bicknell/DCC-Mobile-Decoder/hardware/decoders/README.md

# Index of Decoders

* [Wired-N-1A-8-1](Wired-N-1A-8-1/) Solder Pads, N scale, 1A, 8 function, 9mm x 25mm
