bicknell/DCC-Mobile-Decoder/hardware/decoders/Atlas-N-1A-2-GP40-1/Atlas-N-1A-2-GP40-1.jpg

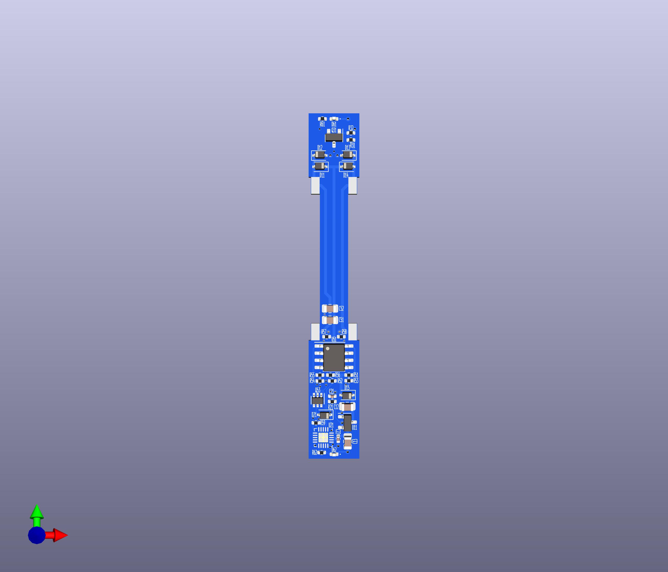
hardware/decoders/Atlas-N-1A-2-GP40-1/Atlas-N-1A-2-GP40-1.jpg
