bicknell/DCC-Mobile-Decoder/hardware/reference/Breadboard-2/CALCULATIONS.xlsx

Sheet: Project
Project Requirements
Description
These are the input electrical requirements as determined by the project specifications. They are used to validate the circuitry is within specifications.
Properties
Ref | Name | Value | Unit | Comment
 | DCC V(max) | 30 | Volts | NMRA Maximum Track Voltage is 27v, the project should be designed with some headroom.
 | DCC V(min) | 6 | Volts | NMRA Minimum Track Voltage is 7 volts, the project should be designed with some headroom.
 | DCC dropout | 4e-05 | Seconds | The maximum duration of the no-power time when the DCC signal switches polarity.
 | µC V | 3.3 | Volts | Operating voltage of the µC.
 | If | 0.1 | Amps | Maximum function current supported.
 | Imax | 1 | Amps | Maximum current across decoder.
 | Ireadback | 0.06 | Amps | NMRA Minimum Readback Pulse
Component Notes
The DCC Signal and Function Outputs need a small signal N-Channel MOSFET. The schematic does not indicate ESD protection on the MOSFET, but it is advisable on any decoder that will see repeated handling like this development board. Functionally any small signal MOSFET with a Vds > 40V, Id > 100ma, and a Vgs < 3.5V are acceptable substututions, including the popular and widely copied 2N7000, 2N7002 and BSS138 parts. Many of the clones have better specifications than the original versions. The ElecSuper BSS138K was chosen as an enhanced BSS138 copy with added ESD protection and high availability and low price at the time this was written.
The Motor Drive requires higher current N & P-Channel MOSFETs to form the H-Bridge. The schematic does not indicate ESD protection on the MOSFET, but it is advisable on any decoder that will see repeated handling like this development board. While the DCC voltage only goes to 27V and the project only requires 1A continuous current, it is advisable to greately over-specify the MOSFETs capabilities so that they operate at a cooler temperature. It is recommended to use parts with Vds > 60V, Id > 2A. Vgs for the P-Channel is not critical due to the drive method. Vgs for the N-Channel must be below the voltage of the MicroController. The Toshiba SSM3J356R,LF was chosen for the P-Channel as it is one of very few P-Channel MOSFETs in this range to include ESD protection. Popular options without ESD protection are the "2309" clones (NEC2309, SI2309, PJM2309, LP2309, etc) and they generally have Id ratings between 1.5A and 2.5A. The Nexperia PMV55ENEA was chosen for the N-Channel as it includes ESD protection. There are several other choices with ESD protection such as the Toshiba SSM3K2615R, or Vishay SQ2364. Popular options without ESD protection are the "2310" clones (CJ2310, AP2310, SL2310, MDD2310, HXY2310AI, SL2310) and they generally have Id ratings between 2A and 3.5A.
For all passive components 0805 (or equivilent) packages have been used. All transistor and MOSFETs are SOT-23. This is a balance of small size but also potential repairability as this is a development board and may be damaged in testing. It should be possible to replace a component by hand without too much difficulty.
When chosing resistors care has been taken to stay with popular E6/E12/E24 values whenever possible, and to design the circuit so 1/16W resistors are of sufficient power handling. This is to support shrinking the circuit to 0201 components which are not generally available in 1/8W variants. While the design allows for 1/16W resistors, the specification is for 1/8W in all cases as they are more readily available in 0805 packages and provide an additional margin of safety.
The exact linear regulator in the Power Supply is not critical. The SE8633X2-HF was chosen entirely based on availability and price. To meet the specifications at the lowest voltages generally an LDO part is required. Take care when swapping regulators to insure the pinout is the same, and the input and output capacitors are sufficient.
The White LEDs in the F0F/F0R and Diag LEDs sections are not critical. The chosen parts were avaialble and low cost at the time of this writing. Any White LED with a Vforward of ~2.9v should work fine. Note that in a real decoder the selection of the F0F and F0R are likely to be important. These LEDs will need to have a color and brightness appropriate to the locomotive, and may need alternate mounting styles such as an edge mount LED or a T1.5 package mounted off the end of the board.

Sheet: 1x Power Supply
Power Supply
Description
SE8633X2-HF is designed for power-sensitive applications. It includes a precision and high voltage input stage, an ultra-low-power bias current branch, and results in a ultra-low-power and low-dropout linear regulator.
Circuit Usage
Regulator to supply power to the µC. A LDO Linear Regulator is acceptable here because the draw by the µC is very small, < 4ma in general. The largest draw on the µC is the directly connected LEDs for the F0F/F0R functions. Diode D15 prevents the motor (Vdrive) from draining capacitor C11 when there is an interruption in power on the track. Provisions are made for a "super-capacitor" to improve performance when there is poor electrical connectivity to the track. C11 may be user installed, up to 1 Farad (1000uF) using capacitors with pitch 2.5mm or 5mm up to a diameter of 10mm.
Properties
Ref | Name | Value | Unit | Comment
D11-D15 | Vrev(max) | 40 | Volts | Maximum repeated reverse voltage.
D11-D15 | Icontinuous | 1 | Amp | Maximum continuous currrent.
D11-D15 | Isurge | 25 | Amps | Maximum surge current.
D11-D15 | Vdrop @1A | 0.6 | Volts | Maximum voltage drop for diodes at 1A.
D11-D15 | Vdrop @10ma | 0.2 | Volts | Approximate based on data sheet graph.
C11 | C11_C | 1 | Farad | Maximum user supplied "super capacitor" supported, DNP.
C11 | C11_esr | 0.16 | Ω | Approximate ESR of the user supplied capacitor.
C12 | C12_V | 50 |  | Maximum voltage of capacitor.
C12 | C12_C | 0.000010 | Farads | Capacitance.
C13 | C13_V | 50 | Volts | Maximum voltage of capacitor.
C13 | C13_C | 0.000010 | Farads | Capacitance.
R11 | R11_R | 4.7 | Ω | Inrush limiting resistor value.
U11 | Vin(max) | 60 | Volts | Maxium input voltage.
U11 | Vin(min) | 2.8 | Volts | Minimum input voltage.
U11 | Vout | 3.3 | Volts | Output voltage (fixed).
U11 | Iout(max) | 0.2 | Amps | Maximum current output.
U11 | Vdif | 0.7 | Volts | Dropout Voltage of the Regulator.
Validations
Num | Check | TRUE/FALSE |  | Description
1 | D11_Vrev(max) = DCC V(max) | TRUE |  | Diodes rated to hadle reverse track voltage.
2 | U11_Vin(max) > Vdrive(max) | TRUE |  | Regulator input rated higher than Vdrive(max).
3 | U11_Vin(min) <= Vreg_in(min) | TRUE |  | Regulator input rated to work at Vdrive(min).
4 | Iout(max) > Vdd I(max) | TRUE |  | Regulator capabiltiies exceed potential max draw.
5 | Vreg_in(min) - Vdif >= µC V | TRUE |  | At Vdrive(min) the regulator can supply the desired output voltage.
6 | C12_V > Vdrive(max) | TRUE |  | Capacitor rated for higher than max voltage.
7 | C13_V > U11_Vout | TRUE |  | Capacitor rated for output voltage.
8 | Tdis(min) > DCC dropout | TRUE |  | Check that the capacitor can hold up the signal for longer than the maximum expected drop out time.
Calculations
Num | Parameter | Calaculation | Unit | Description
1 | Bdrop(max) | 1.2 | Volts | Maximum voltage drop across the bridge.
2 | Vdrive(max) | 28.8 | Volts | Vdrive maximum voltage.
3 | Vdrive(min) | 4.8 | Volts | Vdrive minimum voltage.
4 | Vreg_in(min) | 4.6 | Volts | Vreg_in voltage after passing through D15.
4 | Tdis(typ) | 0.000505 | Seconds | 10% discharge time for C11 @Vdrive(min) w/10ma draw.
5 | Tdis(min) | 0.000080 | Seconds | 10% discharge time for C11 @Vdrive(min) at the PIC max current draw.
6 | Inrush Resistor Minimum | 0.992000 | Ω | Minimum resistance needed to stay inside D11-D14's max surge rating @Vdrive(max).
7 | Inrush with selected R11 | 5.925926 | Amps | Initial inrush current to the capacitor.
Selections
Ref | Component | Size | Sub | MPN
C11 | 50V 10uF X5R 10% | 0805 | Y | Generic Passive
C12 | 50V 10uF X5R 10% | 0805 | Y | Generic Passive
D11-D15 | 40V, 1A Schottky barrier rectifier diode | SOD-323 | Y | 1N5819WS
R11 | 5 Ω 1% 1/8W | 0805 | Y | Generic Passive
U11 | 3.3v Linear Regulator | SOT-23 | Maybe | SE8633X2-HF
Notes
Num | Comment
1

Sheet: 2x Processor
Processor
Description
STM32G031F8P6 is an Arm Cortex-M0+ 32-bit MCU with up to 64KB flash, 8KB RAM, with 2 USARTs, 8 timers, and a 12-bit ADC.
Circuit Usage
µC contolling the project. C21 is a recommened capacitor on the RESET pin to prevent spurrioous resets. C22 is a decoupling capacitor as recommended by the data sheet.
Properties
Ref | Name | Value | Unit | Comment
C21 | C11_C | 0.000000100 | Farad | 5.3.15 NRST input characteristics
C22 | C22_C | 0.000000100 | Farad | 5.1.6 Power supply scheme
C23 | C23_C | 0.000004700 | Farad | 5.1.6 Power supply scheme
U21 | Igpio(max) | 0.015 | Amps | 5.2 Absolute Maximum Ratings
U21 | Iall(max) | 0.080 | Amps | 5.2 Absolute Maximum Ratings
U21 | Vdd Imax | 0.100 | Amps | 5.2 Absolute Maximum Ratings
U21 | Vdd(min) | -0.3 | Volts | 5.2 Absolute Maximum Ratings
U21 | Vdd(max) | 4 | Volts | 5.2 Absolute Maximum Ratings
U21 | Vil TTL Buffer | 0.99 | Volts | 5.3.14 I/O Port Characteristics
U21 | Vih TTL Buffer | 2.31 | Volts | 5.3.14 I/O Port Characteristics
U21 | Max OverDrive | 0.3 | Volts | 47.1 Absolute Maximum Ratings
U21 | Idd(max) | 0.0138 | Amps | 47.3.2 Supply Current (max value in table)
Validations
No | Check | TRUE/FALSE |  | Description
1 | Vdd(min) < Vdd | TRUE |  | Vdd is in range of the part.
2 | Vdd(max) > Vdd | TRUE |  | Vdd is in range of the part.
3 | Iall(max) > Potential Imax | TRUE |  | Current of all outputs simultanously is below chip maximum.
Calculations
No | Value | Calaculation |  | Description
1 | Iout(max) | 0.063 | Amps | If every output simultaneously has maximum current.
Selections
Ref | Component | Size | Sub | MPN
C21 | 50V 100nF X7R 10% | 0805 | Y | Generic Passive Part
C22 | 50V 100nF X7R 10% | 0805 | Y | Generic Passive Part
U21 | STM32G031F8P6 | TSSOP-20 | N | STM32G031F8P6
Notes
Num | Comment
1 | Due to the expected repeated programming the MCLR hold up includes a diode to protect the circuit from repeated high programming voltages.
2 | The following pins are left in their default locations: - PGD, PGC to ease programming connections. - RX, TX, to ease serial connections. - MCLR, Vdd, Gnd, cannot be moved. All other connections were placed to make routing the PCB traces simpler.

Sheet: 3x DCC Signal
DCC Signal
Description
The NMRA requires the decoder to handle a 7-27 volt input signal. That DCC signal needs to be converted to 3.3V logic level for the µC. The BSS138K NPN MOSFET is a widely copied "logic level" MOSFET designed to be turned on and off by a digital circuit. Typically Vdss is 50V, Vgs(th,max) is 1.5v, and Id is at least 300ma. It is not unusual to find work-a-likes with higher Vdss and/or higher Id. The K suffix indicates that the part has an ESD protected gate. Since these boards may be handled by end users going to locomotives this is important to reduce the chance of a MOSFET being damaged by static during handling.
Circuit Usage
Each side of the DCC signal is 1/2 the overall voltage. The MOSFET gate is connected to the DCC input signal and pulled down to ground by a 10K resistor (R32). The pulldown prevents the gate from floating which can damage the MOSFET, but is otherwise not needed in normal operation. A gate resistor (R31) is also included to reduce ringing against the DCC signal. The MOSFET expects the Drain to be pulled up which is accomplished by using the Weak Pull Up in the µC to avoid additional components. Note that it does not matter which rail is used to feed this circuit, RAIL_L or RAIL_R can be picked to make trace routing more convenient.
Properties
Ref | Name | Value | Unit | Comment
R31 | R31_R | 10000 | Ω
R32 | R32_R | 10000 | Ω
Q31 | Vdss | 50 | Volts | Maximum Drain-Source Voltage
Q31 | Vgs(max) | 20 | Volts | Maximum Gate-Source Voltage
Q31 | Vgs(th, max) | 1.5 | Volts | Maximum gate threshold voltage to turn on.
Q31 | Rds(on) | 3.5 | Ω | Typical.
Q31 | Id | 0.31 | Amps | Or greater.
Q31 | Rg | 120 | Ω | Typical.
Validations
No | Check | TRUE/FALSE |  | Description
1 | Q31_Vdss > µC V | TRUE |  | Can handle the voltage we're operating at.
2 | Q31_Vgs(th_max) < Vgs @DCC V(min) | TRUE |  | Will fully turn on at min voltage.
3 | Q31_Vgs(max) > Vgs @DCC V(max) | TRUE |  | Gate max voltage is above project max voltage.
#REF! | R_P < 1/16W | TRUE |  | Check that 1/16W resistors are within limits.
Calculations
No | Value | Calaculation |  | Description
1 | Vgs @DCC V(max) | 15.00 | Volts | DCC V(max) after voltage divider R31/R32
2 | Vgs @DCC V(min) | 3.00 | Volts | DCC V(min) after voltage divider R31/R32
3 | R_P @DCC V(max) | 0.011 | Watts | Power flowing through the voltage divider resistors.
Selections
Ref | Component | Size | Sub | MPN
Q31 | BSS133K | SOT-23 | Y | BSS133K
R31-R32 | 10K Ω 1% 1/8W | 0805 | Y | Generic Passive Part
Notes
Num | Comment
1 | The input pin on the µC MUST be set to input and MUST have the Weak Pull Up enabled.
2 | "Analog Mode" on a decoder is where the decoder also works on a DC track. That is implemented entirely in software. As we pick up the right rail for the DCC signal, if the DC power is applied to the right rail this signal will be high and represents "forward". If the uC is powered up and the pin remains low, power must be on the left rail which represents "reverse". Note that power might be provided by a PWM DC source, so the software should consider a pulsing signal as "forward".

Sheet: 4x Dummy Load
Dummy Load
Description
Passive circuitry to provide a dummy load to the motor driver to enable DCC readback when no motor is connected for development purposes.
Circuit Usage
Most software development can be done without having a motor connected. However, when programming a board via DCC it is supposed to support "readback" where it pulses 60ma of load on the track to indicate acknowledgement. So that the user does not have to connect a motor to develop when JP61 is closed a 100 Ohm resistor is put across the motor output. This allows the board to generate the 60ma pulses, and for readback to function correctly.
Properties
Ref | Name | Value | Unit | Comment
R41 | Ir(steady) | 2 | Amps | Maxium steady state current.
R41 | Ir(pulse) | 10 | Amps | Maximum pulsed current.
R41 | Pr | 2 | Watts | Maximum power dissipation.
R41 | R | 100 | Ω
Validations
Num | Check | TRUE/FALSE |  | Description
1 | Ireadback >= Imin | TRUE |  | Current greater than the project requirement.
2 | Imax < Ir(steady) | TRUE |  | Check that we are in-range with the voltage divider.
3 | P(max) < Pr | FALSE |  | Power dissipation is within in the Resistor's tolerance. See note #1.
Calculations
Num | Parameter | Calaculation | Unit | Description
1 | Imax | 0.300 | Amps | Current @Vdcc(max)
2 | Imin | 0.060 | Amps | Current @Vdcc(min)
3 | P(max) | 9.00 | Watts | Power @Vdcc(max)
4 | P(min) | 0.36 | Watts | Power @Vdcc(min)
5 | Max Supported Voltage | 14.142 | Volts | Maximum track power where 100% throttle will stay within the resistor power limits.
Selections
Ref | Component | Size | Sub | MPN
R41 | 100Ω 2W 5% 2512 | 2512 | N | RC2512JK-7W100RL
Notes
Num
1 | 1. It is not practical to source a resistor that can handle a 100% on duty cycle at maximum track voltage. The goal of this part is to enable DCC readback, which is a series of 60ms pulses, maximum 8 (read back in Direct Mode). Part is safe on Vdrive voltages up to 14.142, which translates to track voltages of 15.342 volts. This should cover the typical N and Z voltage levels on most boosters. The O/G levels with 100% throttle will overdrive the part and damage it. The user must be cautioned.

Sheet: 5x Motor Drive
Motor Drive
Description
For the high side of the circuit, the TOSHIBA SSM3J356R,LF is a 60V 2A P-Channel MOSFET with integrated ESD protection. ESD protection is necessary as the decoders will be handled by people installing them in locomotives.
For low side of the circuit the Nexperia PMV55ENEAR is a 60V, 3.1A N-Channel MOSFET with integrated ESD protection.
The DTC143ZCA is a pre-biased (4.7K & 47K) "digital transitor" which saves two resistors per transitor.
Circuit Usage
The H-Bridge switches the power to the motor to control direction and speed. It uses P-Channel MOSFETs for the high side, and N-Channel MOSFETs for the low side. On the low side the µC voltage is higher than Vgs, and so it can drive the N-Channel MOSFETs directly.
On the high side, the P-Channel is OFF when Q53/Q54 are off and the R51/R52 pullups keep the gate voltage the same as the source voltage (Vgs=0). The P-Channel is on when the transitor is on which drops the gate voltage below the drain voltage. The DCC voltage is also too high for the P-Channel Vgs so a voltage divider is built with R51+R53 and R52+R54. A BJT Q53/Q54 with built in biasing resistors turn on when the uC pin is high, enabling the voltage divider to turn on the MOSFET. Using a BJT with built in biasing resistors saves additional resistors on the board.
It is generally important to turn MOSFETs on and off as quickly as possible to avoid operating them in a high resistance partially on state. Note that R51/R53 use 10k resistors which will grealy reduce the turn on and turn off speed of the high side P-Channel MOSFETs. These high values are used to prevent a signficant current draw when Q53 is on connecting them to ground. In this applicaiton it is acceptable for the P-Channel high side to switch slowly. The software changes the P-Channel state only when direction is changed, and then leaves them fully on or fully off. The PWM signal to modulate speed is applied only to the low side, N-Channel MOSFET which can fast switch.
It is often suggested to use a pull-down resistor on the N-Channel MOSFETs on the low side. The primary concerns seem to be misconfiguration of the uC pin as an input which would leave the gate floating, and increasing the speed of discharge from the MOSFET. It is true that PIC GPIO pins intiially are in an input state, and the gate will be floating. Pins are set as outputs as the third major item (after interrupts and PMD) in the MCC generated files, and counting suggests that setting the pins is about the 11th-14th instructions. Thus any float should be extremely brief. Further, the high side P-Channel MOSFETS are pulled high via resistor, making them off. Thus even if one of the N-Channel MOSFETs were to briefly turn on, no current would flow (e.g. no shoot-through). Because of these mitigating factors, pull downs have been omitted and the totem output of the PIC is relied on to keep the gate from floating.
BackEMF is measured via a voltage divider, but to make it bidirectional it uses 3 resistors. One of R57-R58 will be high and one grounded depending on the polarity of the H-Bridge. Along with R59 they form a voltage divider which is then input to an ADC pin.
Properties
Ref | Name | Value | Unit | Comment
C51-C52 | C51_C | 0.000010 | Farads | Motor decoupling capacitors.
Q51-Q52 | Vdss | -40 | Volts | High Side Drive P-MOS
Q51-Q52 | Vgs | -20 | Volts
Q51-Q52 | Vgs(th, max) | -2.5 | Volts
Q51-Q52 | Rds(on) | 0.240 | Ω | Max
Q51-Q52 | Id | -1.5 | Amps
Q53-Q54 | Vcc | 50 | Volts | High Side gate driver BJT.
Q53-Q54 | Vi(on) | 1.3 | Volts | Max
Q53-Q54 | Ii(max) | 0.0018 | Amps | Max
Q53-Q54 | Io(max) | 0.1 | Amps
Q55-Q56 | Vdss | 60 | Volts | Low Side Drive N-MOS
Q55-Q56 | Vgs | 20 | Volts
Q55-Q56 | Vgs(th, max) | 2.7 | Volts
Q55-Q56 | Rds(on) | 0.060 | Ω | Max
Q55-Q56 | Id | 3.1 | Amps
Q55-Q56 | Rg | 8 | Ω | Typical.
R51-R52 | R51_R | 10000 | Ω | Hold up & voltage divider top.
R53-R54 | R53_R | 10000 | Ω | Voltage divider bottom.
R55-R56 | R55_R | 330 | Ω | Popular E6/E12/E24 value selected to be in range.
R57-R58 | R57_R | 22000 | Ω | BEMF voltage divider resistors.
R59 | R59_R | 3000 | Ω | BEMF voltage divider resistors.
Validations
Num | Check | TRUE/FALSE |  | Description
1 | Q51_Vdss < -1 * Vdcc(max) | TRUE |  | D->S voltage rated higher than maximum DCC voltage.
2 | Q51_Vgs(th,max) > Q51_Vgs(diff) @ Vdcc(min) | TRUE |  | When the driver transistor is on, gate is brought low to ground, check that Vdrive(min) from the power supply is enough to enable.
3 | Q51_Vgs < -1 *Q51_Vgs(diff) @ Vdcc(max) | TRUE |  | When Q51 is driven low, is Vgs within spec.
4 | Q51_Id > Imax | TRUE |  | Maxium current higher than project specification.
5 | Q53_Vcc > Vdcc(max) | TRUE |  | Collector voltage rated higher than maximum DCC voltage.
6 | Q53_Io(max) > Idivider @DCC V(max) | TRUE |  | Rated current is greater than the current drawn by the pullup resistor.
7 | Q53_I(gate) < Igpio(max) | TRUE |  | Current drawn from the µC pin is within the µC rating.
8 | Pdivider < 1/16W | TRUE |  | Check that 1/16W resistors are within limits.
9 | Q55_Vdss > DCC (max) | TRUE |  | D->S voltage rated higher than maximum DCC voltage.
10 | Q55_Vgs(th, max) < µC V | TRUE |  | Gate threshold voltage below µC operating voltage.
11 | Q55_Vgs > µC V | TRUE |  | When Q55 is driven high, is Vgs within spec.
12 | Q55_Id > Imax | TRUE |  | Maxium current higher than project specification.
13 | Q55_Max Gate I < Igpio (max) | TRUE |  | Gate resistor keeps current below µC max.
14 | Vbackemf(max) < µC V | TRUE |  | Maximum voltage on the BackEMF measurement is within range of the ADC on the µC.
15 | Pbackemf_divider < 1/16W | TRUE |  | Check that 1/16W resistors are within limits.
Calculations
Num | Parameter | Calaculation | Unit | Description
1 | Q51_Vdivider(max) | 15 | Volts | Voltage when Q53 is on formed by the R51/Rxx voltage divider.
2 | Q51_Vdivider(min) | 3 | Volts | Voltage when Q53 is on formed by the R51/Rxx voltage divider.
 | Q51_Vgs(diff) @ Vdcc(max) | 15 | Volts | Voltage difference applied to the gate @Vdcc(max).
 | Q51_Vgs(diff) @ Vdcc(min) | 3 | Volts | Voltage difference applied to the gate @Vdcc(min).
3 | Q55_Minimum Gate Resistor | 220 | Ω | Minimum value to stay within spec.
4 | Q55_Igate(max) | 0.010 | Amps | Max inrush, based on selected value.
5 | Idivider @DCC V(max) | 0.002 | Amps | Current flowing through the voltage divider resistor.
6 | Pdivider | 0.045 | Watts | Power dissipated by the voltage divider resistors.
7 | Q53_I(gate) | 0.000255 | Amps | Gate current into the BJT.
8 | Rbackemf_bottom | 2640 | Ω | Effective bottom resistance of the BackEMF voltage divider.
9 | Vbackemf @DCC V(max) | 3.2 | Volts | Maximum voltage created by the BackEMF resistor-dividers.
10 | Pbackemf_divider | 0.037 | Watts
Selections
Ref | Component | Size | Sub | MPN
C51-C52 | 50V 10uF X5R 10% | 0805 | Y | Generic Passive Part
Q51-Q52 | 40V 1.5A P Channel | SOT-23 | N | PMV250EPEA
Q53-Q54 | 50V 100ma NPN - Pre Biased 4.7K/47K | SOT-23 | N | DTC143ZCA
Q55-Q56 | 60V 1.6A N Channel | SOT-23 | N | DMN6140
R51-R52 | 10K Ω 1% 1/8W | 0805 | Y | Generic Passive Part
R53-R54 | 10K Ω 1% 1/8W | 0805 | Y | Generic Passive Part
R55-R56 | 330 Ω 1% 1/8W | 0805 | Y | Generic Passive Part
R57-R58 | 22K Ω 1% 1/8W | 0805 | Y | Generic Passive Part
R59 | 3K Ω 1% 1/8W | 0805 | Y | Generic Passive Part
Notes
Num | Comment
1

Sheet: 6x F0F-F0R
F0F-F0R
Description
Bright White, 25ma, Vf 2.9v generic SMD LED used for the headlight and taillight. Described as a "constant brightness headlight" in the decoder industry as it is driven from the regulated voltage.
Circuit Usage
Indicator F0F or F0R is on.
Properties
Num | Name | Value | Unit | Comment
D61-D62 | Vforward | 2.9 | Volts
D61-D62 | Imax | 0.025 | Amps
R61-R62 | R61_R | 330 | Ω | Popular E6/E12/E24 value selected to be in range.
Validations
Num | Check | TRUE/FALSE |  | Description
1 | Id < Imax | TRUE |  | Current is within the LED limit.
2 | Id >= 0.001 | TRUE |  | Current in > 1ma to light.
3 | R61_Pd < 1/16W | TRUE |  | Check that 1/16W resistors are within limits.
Calculations
Num | Parameter | Calaculation | Unit | Description
1 | R(min) | 16 | Ω | Resistor value for Imax current.
2 | R(max) | 400 | Ω | Resistor value for 0.001A current.
3 | Id | 0.001212 | Amps | Current through the LED
4 | Pd | 0.004000 | Watts | Power dissipated by LED
5 | R61_Pd | 0.004000 | Watts
Selections
Ref | Component | Size | Sub | MPN
R61-R62 | 330 Ω 1% 1/8W | 0805 | Y | Generic Passive Part
Notes
Num | Comment
1

Sheet: 7x Function Outputs
Function Outputs
Description
The BSS138K NPN MOSFET is a widely copied "logic level" MOSFET designed to be turned on and off by a digital circuit. Typically Vdss is 50V, Vgs(th,max) is 1.5v, and Id is at least 200ma. It is not unusual to find work-a-likes with higher Vdss and/or higher Id. The K suffix indicates that the part has an ESD protected gate. Since these boards may be handled by end users going to locomotives this is important to reduce the chance of a MOSFET being damaged by static during handling.
Circuit Usage
External devices are connected in a common anode (postive) configuration, with each function having a low side MOSFET to turn it on and off.
Properties
Num | Name | Value | Unit | Comment
Q71-Q76 | Vdss | 50 | Volts | Or greater.
Q71-Q76 | Vgs(th, max) | 1.5 | Volts | Typical.
Q71-Q76 | Rds(on) | 3.5 | Ω | Typical.
Q71-Q76 | Id | 0.2 | Amps | Or greater.
Q71-Q76 | Rg | 69 | Ω | Typical.
R71-R76 | R71_R | 330 | Ω | Popular E6/E12/E24 value selected to be in range.
Validations
Num | Check | TRUE/FALSE |  | Description
1 | Vdss > DCC (max) | TRUE |  | D->S voltage higher than maximum DCC voltage.
2 | Vgs < µC V | TRUE |  | Gate threshold voltage below µC operating voltage.
3 | Id > If | TRUE |  | Maxium current higher than project specification.
4 | Max Gate I < Igpio (max) | TRUE |  | Gate resistor keeps current below µC max.
5 | Max Total I < Iall(max) | TRUE |  | Check that all functions together are below the µC total output current.
Calculations
Num | Parameter | Calaculation | Unit | Description
 | Max Gate I | 0.010 | Amps | Max inrush, based on selected value.
 | Max Total I | 0.060 | Amps | Max inrush, all 6 in unison.
Selections
Ref | Component | Size | Sub | MPN
Q31 | BSS133K | SOT-23 | Y | BSS133K
R71-R76 | 330 Ω 1% 1/8W | 0805 | Y | Generic Passive Part
Notes
Num
1 | Most likely R71-R76 are not necessary. The inrush is so short lived due to the small total gate charge that it is unlikely to damage the micro. In space-constrained designs omitting these resistors may save board space.

Sheet: 8x Diag LEDs
Function Outputs
Description
Bright White, 25ma, Vf 2.9v generic SMD LED are connected to each function.
Circuit Usage
These would be omitted on any real decoder and are present to assist in software development only. These are connected to Vdrive, and thus need to be able to handle the full range of track voltages.
Properties
Ref | Name | Value | Unit | Comment
D81-D86 | Vforward(white) | 2.9 | Volts
D87 | Vforward(red) | 1.95 | Volts
D87 | Vforward(green) | 1.95 | Volts
D81-D86 | Imax | 0.025 | Amps
D81-D86 | Pd | 0.080 | Watts
R81-R86 | R81_R | 3000 | Ω
D87 | Vforward(red) | 1.95 | Volts
D87 | Vforward(green) | 1.95 | Volts
D87 | Imax | 0.025 | Amps
D87 | Pd | 0.055 | Watts
R87 | R87_R | 3000 | Ω
Validations
Num | Check | TRUE/FALSE |  | Description
1 | Id(white)@Vdcc(max) < Imax | TRUE |  | Current is within the LED limit.
2 | Id(white)@Vdcc(min) > 1ma | TRUE |  | At least 1ma to light the LED properly.
3 | Id(red)@Vdcc(max) < Imax | TRUE |  | Current is within the LED limit.
4 | Id(red)@Vdcc(min) > 1ma | TRUE |  | At least 1ma to light the LED properly.
5 | Id(green)@Vdcc(max) < Imax | TRUE |  | Current is within the LED limit.
6 | Id(green)@Vdcc(min) > 1ma | TRUE |  | At least 1ma to light the LED properly.
7 | Pd(white,max) < Pd | TRUE
8 | Pd(red-green,max) < Pd | TRUE
Calculations
Num | Parameter | Calaculation | Unit | Description
1 | R(white,min) @Vdcc(max) | 1084 | Ω | Minimum resistor to stay under Imax @Vdcc(max)
2 | R(red,min) @Vdcc(max) | 1122 | Ω | Minimum resistor to stay under Imax @Vdcc(max)
3 | R(greem,min) @Vdcc(max) | 1122 | Ω | Minimum resistor to stay under Imax @Vdcc(max)
4 | R(white,max) @Vdcc(min) | 3100 | Ω | Maximum resistor to allow at least 1ma @Vdcc(min)
5 | R(red,max) @Vdcc(min) | 4050 | Ω | Maximum resistor to allow at least 1ma @Vdcc(min)
6 | R(green,max) @Vdcc(min) | 4050 | Ω | Maximum resistor to allow at least 1ma @Vdcc(min)
7 | Id(white) @Vdcc(max) | 0.009033 | Amps | Current through LED @Vdcc(max).
8 | Id(white) @Vdcc(min) | 0.001033 | Amps | Current through LED @Vdcc(min).
9 | Id(red) @Vdcc(max) | 0.009350 | Amps | Current through LED @Vdcc(max).
10 | Id(red) @Vdcc(min) | 0.001350 | Amps | Current through LED @Vdcc(min).
11 | Id(green) @Vdcc(max) | 0.009350 | Amps | Current through LED @Vdcc(max).
12 | Id(green) @Vdcc(min) | 0.001350 | Amps | Current through LED @Vdcc(min).
13 | Pd(white) @Vdcc(max) | 0.026 | Watts | Power dissipated by LED @Vdcc(max).
14 | Pd(green,red) @Vdcc(max) | 0.018 | Watts | Power dissipated by LED @Vdcc(max).
Selections | Selections
Ref | Component | Size | Sub | MPN
R81-R87 | 3K Ω 1% 1/8W | 0805 | Y | Generic Passive
Notes
Num
1

Sheet: 9x External
External Connectivity
Description
0.1" pin headers to connect to external devices. Headers are supplied unpopulated so the user can populate only the ones needed for their application.
Circuit Usage
Allows connecting to a bread board, an ICSP programmer, a TTL-to-USB serial adapter, and an oscilloscope.
Notes
Num
J1 | A 6 pin header designed to fit into a standard breadboard.
J2 | A 6 pin header designed to fit into a standard breadboard.
J3 | An SW programming header.
J4 | A 7 pin header that exposes the DCC signal along with the motor drives and BackEMF. The expected usage is to connect an oscilloscope which is likely necessary for some motor control work.
J5 | A 5 pin header with the typical pin layout of many TTL-to-USB adapters. This allows a computer to send and receive RS-232 serial data from the uC.
