bicknell/DCC-Mobile-Decoder/hardware/decoders/Atlas-N-1A-2-GP40-1/CALCULATIONS.xlsx

Sheet: Project
Project Requirements
Description
These are the input electrical requirements as determined by the project specifications. They are used to validate the circuitry is within specifications.
Properties
Ref | Name | Value | Unit | Comment
 | DCC V(max) | 30 | Volts | NMRA Maximum Track Voltage is 27v, the project should be designed with some headroom.
 | DCC V(min) | 6 | Volts | NMRA Minimum Track Voltage is 7 volts, the project should be designed with some headroom.
 | DCC dropout | 4e-05 | Seconds | The maximum duration of the no-power time when the DCC signal switches polarity.
 | µC V | 3.3 | Volts | Operating voltage of the µC.
 | If | 0.1 | Amps | Maximum function current supported.
 | Imax | 1 | Amps | Maximum current across decoder.
 | Ireadback | 0.06 | Amps | NMRA Minimum Readback Pulse

Sheet: Power Supply
Power Supply
Description
SE8633X2-HF is designed for power-sensitive applications. It includes a precision and high voltage input stage, an ultra-low-power bias current branch, and results in a ultra-low-power and low-dropout linear regulator.
Circuit Usage
Regulator to supply power to the µC. A LDO Linear Regulator is acceptable here because the draw by the µC is very small, < 4ma in general. The largest draw on the µC is the directly connected LEDs for the F0F/F0R functions. Diode D15 prevents the motor (Vdrive) from draining capacitor C11 when there is an interruption in power on the track. Provisions are made for a "super-capacitor" to improve performance when there is poor electrical connectivity to the track. C11 may be user installed, up to 1 Farad (1000uF) using capacitors with pitch 2.5mm or 5mm up to a diameter of 10mm.
Properties
Ref | Name | Value | Unit | Comment
D11-D15 | Vrev(max) | 40 | Volts | Maximum repeated reverse voltage.
D11-D15 | Icontinuous | 1 | Amp | Maximum continuous currrent.
D11-D15 | Isurge | 25 | Amps | Maximum surge current.
D11-D15 | Vdrop @1A | 0.6 | Volts | Maximum voltage drop for diodes at 1A.
D11-D15 | Vdrop @10ma | 0.2 | Volts | Approximate based on data sheet graph.
C11 | C11_C | 1 | Farad | Maximum user supplied "super capacitor" supported, DNP.
C12 | C12_V | 50 |  | Maximum voltage of capacitor.
C12 | C12_C | 0.000010 | Farads | Capacitance.
C13 | C13_V | 50 | Volts | Maximum voltage of capacitor.
C13 | C13_C | 0.000010 | Farads | Capacitance.
R11 | R11_R | 4.7 | Ω | Inrush limiting resistor value.
U11 | Vin(max) | 60 | Volts | Maxium input voltage.
U11 | Vin(min) | 2.8 | Volts | Minimum input voltage.
U11 | Vout | 3.3 | Volts | Output voltage (fixed).
U11 | Iout(max) | 0.2 | Amps | Maximum current output.
U11 | Vdif | 0.7 | Volts | Dropout Voltage of the Regulator.
Validations
Num | Check | TRUE/FALSE |  | Description
1 | D11_Vrev(max) = DCC V(max) | TRUE |  | Diodes rated to hadle reverse track voltage.
2 | U11_Vin(max) > Vdrive(max) | TRUE |  | Regulator input rated higher than Vdrive(max).
3 | U11_Vin(min) <= Vreg_in(min) | TRUE |  | Regulator input rated to work at Vdrive(min).
4 | Iout(max) > Vdd I(max) | TRUE |  | Regulator capabiltiies exceed potential max draw.
5 | Vreg_in(min) - Vdif >= µC V | TRUE |  | At Vdrive(min) the regulator can supply the desired output voltage.
6 | C12_V > Vdrive(max) | TRUE |  | Capacitor rated for higher than max voltage.
7 | C13_V > U11_Vout | TRUE |  | Capacitor rated for output voltage.
8 | Tdis(min) > DCC dropout | TRUE |  | Check that the capacitor can hold up the signal for longer than the maximum expected drop out time.
Calculations
Num | Parameter | Calaculation | Unit | Description
1 | Bdrop(max) | 1.2 | Volts | Maximum voltage drop across the bridge.
2 | Vdrive(max) | 28.8 | Volts | Vdrive maximum voltage.
3 | Vdrive(min) | 4.8 | Volts | Vdrive minimum voltage.
4 | Vreg_in(min) | 4.6 | Volts | Vreg_in voltage after passing through D15.
4 | Tdis(typ) | 0.000505 | Seconds | 10% discharge time for C11 @Vdrive(min) w/10ma draw.
5 | Tdis(min) | 0.000095 | Seconds | 10% discharge time for C11 @Vdrive(min) at the PIC max current draw.
6 | Inrush Resistor Minimum | 1.152000 | Ω | Minimum resistance needed to stay inside D11-D14's max surge rating @Vdrive(max).
7 | Inrush with selected R11 | 6.127660 | Amps | Initial inrush current to the capacitor.
Selections
Ref | Component | Size | Sub | MPN
C11 | 50V 10uF X5R 10% | 0805 | Y | Generic Passive
C12 | 50V 10uF X5R 10% | 0805 | Y | Generic Passive
D11-D15 | 40V, 1A Schottky barrier rectifier diode | SOD-323 | Y | 1N5819WS
Notes
Num | Comment
1

Sheet: Processor
Processor
Description
PIC18-Q40 is a compact, high performance PIC18 product family for real-time control and sensor applications . The products are equipped with an 12-bit ADC with Computation, 8-bit DACs, 16-bit PWMs, Direct Memory Access, Configurable Logic Cells and multiple communication interfaces. The PIC18-Q40 offers 14- and 20-pin products in small footprint packages to support customers in a wide range of space constrained applications.
Circuit Usage
µC contolling the project. R21 & C21 form a hold up circuit for the MCLR pin, while D21 protects the rest of the circuit while programming. During programming Vdd can be raised to 12-13v, and without the diode would backfeed components. C22 is a decoupling capacitor as recommended by the data sheet.
Properties
Ref | Name | Value | Unit | Comment
C21 | C11_C | 0.000000100 | Farad | MCLR hold up capacitor, value not critical.
C22 | C22_C | 0.000000100 | Farad | U21 Section 4.2.1 recommended value.
D21 | Vrev(max) | 40 | Volts | Maximum repeated reverse voltage.
D21 | Vdrop @1ma | 0.2 | Volts | Approximate drop at 1ma load per the data sheet graph.
R21 | R21_R | 10000 | Ω | U21 Section 4.3 recommended value.
U21 | Igpio(max) | 0.025 | Amps | 47.1 Absolute Maximum Ratings
U21 | Iall(max) | 0.07 | Amps | 47.1 Absolute Maximum Ratings
U21 | Vdd Imax | 0.19 | Amps | 47.1 Absolute Maximum Ratings
U21 | Vdd(min) | 1.8 | Volts | 47.3.1 Supply Voltage Param. No. D002
U21 | Vdd(max) | 5.5 | Volts | 47.3.1 Supply Voltage Param. No. D002
U21 | Vil TTL Buffer | 0.009 | Volts | 47.3.4 I/O Ports Param. No. D300
U21 | Vih TTL Buffer | 0.815 | Volts | 47.3.4 I/O Ports Param. No. D320
U21 | Max OverDrive | 0.3 | Volts | 47.1 Absolute Maximum Ratings
U21 | Idd(max) | 0.0138 | Amps | 47.3.2 Supply Current (max value in table)
Validations
No | Check | TRUE/FALSE |  | Description
1 | Vdd(min) < Vdd | TRUE |  | Vdd is in range of the part.
2 | Vdd(max) > Vdd | TRUE |  | Vdd is in range of the part.
3 | Iall(max) > Potential Imax | TRUE |  | Current of all outputs simultanously is below chip maximum.
4 | R21_P < 1/8W | TRUE |  | Check that 1/8W resistors are within limits.
Calculations
No | Value | Calaculation |  | Description
1 | Iout(max) | 0.053 | Amps | If every output simultaneously has maximum current.
2 | R21_I | 0.000330 | Amps | Power consumed by MCLR hold up.
3 | R21_P | 0.001089 | Watts
Selections
Ref | Component | Size | Sub | MPN
C21 | 50V 100nF X7R 10% | 0805 | Y | Generic Passive Part
C22 | 50V 100nF X7R 10% | 0805 | Y | Generic Passive Part
R21 | 680 Ω 1% 1/8W | 0805 | Y | Generic Passive Part
R22 | 9.1K Ω 1% 1/8W | 0805 | Y | Generic Passive Part
U21 | PIC18F16Q40 | SSOP-20 | N | PIC18F16Q40T-I/SS
Notes
Num | Comment
1

Sheet: DCC Signal
DCC Signal
Description
The NMRA requires the decoder to handle a 7-27 volt input signal. That DCC signal needs to be converted to 3.3V logic level for the µC.
Circuit Usage
R31 & R32 form a voltage divider to lower the track voltage range to the Gate voltage range of a 2N7002 MOSFET. The MOSFET connects an input pin to ground when on. When off a weak pull up resistor inside the µC pulls the pin high.
Properties
Ref | Name | Value | Unit | Comment
R31 | R31_R | 10000 | Ω
R32 | R32_R | 10000 | Ω
Q31 | Vdss | 60 | Volts | Maximum Drain-Source Voltage
Q31 | Vgs(max) | 20 | Volts | Maximum Gate-Source Voltage
Q31 | Vgs(th, max) | 2.5 | Volts | Maximum gate threshold voltage to turn on.
Q31 | Rds(on) | 2.5 | Ω | Typical.
Q31 | Id | 0.115 | Amps | Or greater.
Q31 | Ciss(max) | 5e-08 | Columbs | Typical.
Q31 | Rg | 120 | Ω | Typical.
Validations
No | Check | TRUE/FALSE |  | Description
1 | Q31_Vdss > µC V | TRUE
2 | Q31_Vgs(th_max) < Vgs @DCC V(max) | TRUE
3 | Q31_Vgs(th_max) < Vgs @DCC V(min) | TRUE
4 | Q31)Vgs(max) > Vgs @DCC V(max) | TRUE
5 | Q31)Vgs(max) > Vgs @DCC V(min) | TRUE
6 | R31_P < 1/8W | TRUE |  | Check that 1/8W resistors are within limits.
7 | R31_P < 1/8W | TRUE |  | Check that 1/8W resistors are within limits.
Calculations
No | Value | Calaculation |  | Description
1 | Vgs @DCC V(max) | 15 | Volts
2 | Vgs @DCC V(min) | 3 | Volts
3 | R31_P @DCC V(max) | 0.022 | Watts | Power flowing through the voltage divider resistor
4 | R32_P @DCC V(max) | 0.022 | Watts | Power flowing through the voltage divider resistor
Selections
Ref | Component | Size | Sub | MPN
R31-R32 | 10K Ω 1% 1/8W | 0805 | Y | Generic Passive Part
Notes
Num | Comment
1 | The input pin on the µC MUST be set to input and MUST have the Weak Pull Up enabled.
2 | "Analog Mode" on a decoder is where the decoder also works on a DC track. That is implemented entirely in software. As we pick up the right rail for the DCC signal, if the DC power is applied to the right rail this signal will be high and represents "forward". If the uC is powered up and the pin remains low, power must be on the left rail which represents "reverse". Note that power might be provided by a PWM DC source, so the software should consider a pulsing signal as "forward".

Sheet: Motor Drive
Motor Drive
Description
For the high side of the circuit, the SL2309 is a 60V 1.6A P-Channel MOSFET. For low side of the circuit the DMN6140 is a 60V, 2.1A N-Channel MOSFET. Both MOSFETs are designed for power switching applications. The DTC143ZCA is a pre-biased (4.7K & 47K) "digital transitor" which saves two resistors per transitor.
Circuit Usage
The H-Bridge switches the power to the motor to control direction and speed. It uses P-Channel MOSFETs for the high side, and N-Channel MOSFETs for the low side. While the uC can drive the low side directly, it can't drive the high side to full off. A pull up resistor and a BJT with built in biasing resistors are used to switch the gate from Vdrive to ground. Using a BJT with built in biasing resistors saves additional resistors on the board. BackEMF is measured via a voltage divider, but to make it bidirectional it uses 3 resistors. One of R53-R54 will be high, and one grounded depending on the configuration of the H-Bridge. Along with R57 they form a voltage divider which is then input to an ADC pin.
Properties
Ref | Name | Value | Unit | Comment
C51-C52 | C51_C | 0.000010 | Farads | Motor decoupling capacitors.
Q51-Q52 | Vdss | 60 | Volts | High Side Drive P-MOS
Q51-Q52 | Vgs(th, max) | -2.5 | Volts
Q51-Q52 | Rds(on) | 0.45 | Ω | Max
Q51-Q52 | Id | -2 | Amps
Q53-Q54 | Vcc | 50 | Volts | High Side gate driver BJT.
Q53-Q54 | Vi(on) | 1.3 | Volts | Max
Q53-Q54 | Ii(max) | 0.0018 | Amps | Max
Q53-Q54 | Io(max) | 0.1 | Amps
Q55-Q56 | Vdss | 60 | Volts | Low Side Drive N-MOS
Q55-Q56 | Vgs(th, max) | 3 | Volts
Q55-Q56 | Rds(on) | 0.17 | Ω | Max
Q55-Q56 | Id | 1.2 | Amps | Max @70C
Q55-Q56 | Rg | 120 | Ω | Typical.
R51-R52 | R51_R | 10000 | Ω | Hold up, value not critical.
R53-R54 | R53_R | 3000 | Ω | BEMF voltage divider resistors.
R55-R56 | R55_R | 390 | Ω | Gate protection resistors.
R57 | R57_R | 390 | Ω | BEMF voltage divider resistors.
Validations
Num | Check | TRUE/FALSE |  | Description
1 | Q51_Vdss > Vdcc(max) | TRUE |  | D->S voltage rated higher than maximum DCC voltage.
2 | Q51_Vgs(th,max) > Vdrive(min) | TRUE |  | When the driver transistor is on, gate is brought low to ground, check that Vdrive(min) from the power supply is enough to enable.
3 | Q51_Id > Imax | TRUE |  | Maxium current higher than project specification.
4 | Q53_Vcc > Vdcc(max) | TRUE |  | Collector voltage rated higher than maximum DCC voltage.
5 | Q53_Io(max) > Ipullup @DCC V(max) | TRUE |  | Rated current is greater than the current drawn by the pullup resistor.
6 | Q53_I(gate) < Igpio(max) | TRUE |  | Current drawn from the µC pin is within the µC rating.
7 | Ppullup < 1/8W | TRUE |  | 1/8 Watt resistors sufficient.
8 | Q55_Vdss > DCC (max) | TRUE |  | D->S voltage rated higher than maximum DCC voltage.
9 | Q55_Vgs < µC V | TRUE |  | Gate threshold voltage below µC operating voltage.
10 | Q55_Id > Imax | TRUE |  | Maxium current higher than project specification.
11 | Q55_Max Gate I < Igpio (max) | TRUE |  | Gate resistor keeps current below µC max.
12 | Vbackemf(max) < µC V | TRUE |  | Maximum voltage on the BackEMF measurement is within range of the ADC on the µC.
Calculations
Num | Parameter | Calaculation | Unit | Description
1 | Q55_Minimum Gate Resistor | 132 | Ω | Minimum value to stay within spec.
2 | Q55_Igate(max) | 0.008 | Amps | Max inrush, based on selected value.
3 | Ipullup @DCC V(max) | 0.003 | Amps | Current flowing through the Pullup resistor.
4 | Ppullup | 0.090 | Watts | Power dissipated by the Pullup resistor.
5 | Q53_I(gate) | 0.000064 | Amps | Gate current into the BJT.
6 | Rbackemf_bottom | 345.1327434 | Ω
7 | Vbackemf @DCC V(max) | 3.1 | Volts | Maximum voltage created by the BackEMF resistor-dividers.
Selections
Ref | Component | Size | Sub | MPN
C51-C52 | 50V 10uF X5R 10% | 0805 | Y | Generic Passive Part
Q51-Q52 | 60V 1.6A P Channel | SOT-23 | N | SL2309
Q53-Q54 | 50V 100ma NPN - Pre Biased 4.7K/47K | SOT-23 | N | DTC143ZCA
Q55-Q56 | 60V 1.6A N Channel | SOT-23 | N | DMN6140
R51-R52 | 10K Ω 1% 1/8W | 0805 | Y | Generic Passive Part
R53-R54 | 3.6K Ω 1% 1/8W | 0805 | Y | Generic Passive Part
R55-R56 | 680 Ω 1% 1/8W | 0805 | Y | Generic Passive Part
R57 | 470 Ω 1% 1/8W | 0805 | Y | Generic Passive Part
Notes
Num | Comment
1

Sheet: F0F-F0R
F0F-F0R
Description
Bright White, 25ma, Vf 2.9v generic SMD LED used for the headlight and taillight. Described as a "constant brightness headlight" in the decoder industry as it is driven from the regulated voltage.
Circuit Usage
Indicator F0F or F0R is on.
Properties
Num | Name | Value | Unit | Comment
D61-D62 | Vforward | 2.9 | Volts
D61-D62 | Imax | 0.025 | Amps
R61-R62 | R61_R | 390 | Ω
Validations
Num | Check | TRUE/FALSE |  | Description
1 | Id < Imax | TRUE |  | Current is within the LED limit.
2 | Id >= 0.001 | TRUE |  | Current in > 1ma to light.
Calculations
Num | Parameter | Calaculation | Unit | Description
1 | R(min) | 16 | Ω | Resistor value for Imax current.
2 | R(max) | 400 | Ω | Resistor value for 0.001A current.
3 | Id | 0.001026 | Amps | Current through the LED
4 | Pd | 0.003384615385 | Watts | Power dissipated by LED
Selections
Ref | Component | Size | Sub | MPN
R61-R62 | 680 Ω 1% 1/8W | 0805 | Y | Generic Passive Part
Notes
Num | Comment
1

Sheet: Function Outputs
Function Outputs
Description
The 2N7002 NPN MOSFET is a widely copied "logic level" MOSFET designed to be turned on and off by a digital circuit. Typically Vdss is 60V, Vgs(th) is 2.5v, and Id is at least 100ma at maximum temperature mounted to normal FR4. It is not unusual to find enhanced versions of this part with increased current capability. Typically available in SOT-23, SOT-323, SOT-523, and DFN packages.
Circuit Usage
External devices are connected in a common anode (postive) configuration, with each function having a low side MOSFET to turn it on and off.
Properties
Num | Name | Value | Unit | Comment
Q71-Q76 | Vdss | 60 | Volts
Q71-Q76 | Vgs(th, max) | 2.5 | Volts
Q71-Q76 | Rds(on) | 2.5 | Ω | Typical.
Q71-Q76 | Id | 0.115 | Amps | Or greater.
Q71-Q76 | Ciss(max) | 5e-08 | Columbs | Typical.
Q71-Q76 | Rg | 120 | Ω | Typical.
R71-R76 | R71_R | 390 | Ω | Popular E6 value selected to be in range.
Validations
Num | Check | TRUE/FALSE |  | Description
1 | Vdss > DCC (max) | TRUE |  | D->S voltage higher than maximum DCC voltage.
2 | Vgs < µC V | TRUE |  | Gate threshold voltage below µC operating voltage.
3 | Id > If | TRUE |  | Maxium current higher than project specification.
4 | Max Gate I < Igpio (max) | TRUE |  | Gate resistor keeps current below µC max.
5 | Max Total I < Iall(max) | TRUE |  | Check that all functions together are below the µC total output current.
Calculations
Num | Parameter | Calaculation | Unit | Description
 | Max Gate I | 0.008 | Amps | Max inrush, based on selected value.
 | Max Total I | 0.051 | Amps | Max inrush, all 6 in unison.
Selections
Ref | Component | Size | Sub | MPN
R71-R76 | 680 Ω 1% 1/8W | 0805 | Y | Generic Passive Part
Notes
Num
1 | Most likely R71-R76 are not necessary. The inrush is so short lived due to the small total gate charge that it is unlikely to damage the micro. In space-constrained designs omitting these resistors may save board space.

Sheet: Diag LEDs
Function Outputs
Description
Bright White, 25ma, Vf 2.9v generic SMD LED are connected to each function.
Circuit Usage
These would be omitted on any real decoder and are present to assist in software development only. These are connected to Vdrive, and thus need to be able to handle the full range of track voltages.
Properties
Ref | Name | Value | Unit | Comment
D81-D86 | Vforward(white) | 2.9 | Volts
D87 | Vforward(red) | 1.95 | Volts
D87 | Vforward(green) | 1.95 | Volts
D81-D86 | Imax | 0.025 | Amps
D81-D86 | Pd | 0.080 | Watts
R81-R86 | R81_R | 3000 | Ω
D87 | Vforward(red) | 1.95 | Volts
D87 | Vforward(green) | 1.95 | Volts
D87 | Imax | 0.025 | Amps
D87 | Pd | 0.055 | Watts
R87 | R87_R | 3000 | Ω
Validations
Num | Check | TRUE/FALSE |  | Description
1 | Id(white)@Vdcc(max) < Imax | TRUE |  | Current is within the LED limit.
2 | Id(white)@Vdcc(min) > 1ma | TRUE |  | At least 1ma to light the LED properly.
3 | Id(red)@Vdcc(max) < Imax | TRUE |  | Current is within the LED limit.
4 | Id(red)@Vdcc(min) > 1ma | TRUE |  | At least 1ma to light the LED properly.
5 | Id(green)@Vdcc(max) < Imax | TRUE |  | Current is within the LED limit.
6 | Id(green)@Vdcc(min) > 1ma | TRUE |  | At least 1ma to light the LED properly.
7 | Pd(white,max) < Pd | TRUE
8 | Pd(red-green,max) < Pd | TRUE
Calculations
Num | Parameter | Calaculation | Unit | Description
1 | R(white,min) @Vdcc(max) | 1084 | Ω | Minimum resistor to stay under Imax @Vdcc(max)
2 | R(red,min) @Vdcc(max) | 1122 | Ω | Minimum resistor to stay under Imax @Vdcc(max)
3 | R(greem,min) @Vdcc(max) | 1122 | Ω | Minimum resistor to stay under Imax @Vdcc(max)
4 | R(white,max) @Vdcc(min) | 3100 | Ω | Maximum resistor to allow at least 1ma @Vdcc(min)
5 | R(red,max) @Vdcc(min) | 4050 | Ω | Maximum resistor to allow at least 1ma @Vdcc(min)
6 | R(green,max) @Vdcc(min) | 4050 | Ω | Maximum resistor to allow at least 1ma @Vdcc(min)
7 | Id(white) @Vdcc(max) | 0.009033 | Amps | Current through LED @Vdcc(max).
8 | Id(white) @Vdcc(min) | 0.001033 | Amps | Current through LED @Vdcc(min).
9 | Id(red) @Vdcc(max) | 0.009350 | Amps | Current through LED @Vdcc(max).
10 | Id(red) @Vdcc(min) | 0.001350 | Amps | Current through LED @Vdcc(min).
11 | Id(green) @Vdcc(max) | 0.009350 | Amps | Current through LED @Vdcc(max).
12 | Id(green) @Vdcc(min) | 0.001350 | Amps | Current through LED @Vdcc(min).
13 | Pd(white) @Vdcc(max) | 0.026 | Watts | Power dissipated by LED @Vdcc(max).
14 | Pd(green,red) @Vdcc(max) | 0.018 | Watts | Power dissipated by LED @Vdcc(max).
Selections | Selections
Ref | Component | Size | Sub | MPN
R81-R87 | 3K Ω 1% 1/8W | 0805 | Y | Generic Passive
Notes
Num
1

Sheet: External
External Connectivity
Description
0.1" pin headers to connect to external devices. Headers are supplied unpopulated so the user can populate only the ones needed for their application.
Circuit Usage
Allows connecting to a bread board, an ICSP programmer, a TTL-to-USB serial adapter, and an oscilloscope.
Notes
Num
J1 | A 6 pin header designed to fit into a standard breadboard.
J2 | A 6 pin header designed to fit into a standard breadboard.
J3 | An ISCP programming header with the typical pin layout for connecting a programing device like a PICKIT4.
J4 | A 7 pin header that exposes the DCC signal along with the motor drives and BackEMF. The expected usage is to connect an oscilloscope which is likely necessary for some motor control work.
J5 | A 5 pin header with the typical pin layout of many TTL-to-USB adapters. This allows a computer to send and receive RS-232 serial data from the uC.

Sheet: Dummy Load
Dummy Load
Description
Passive circuitry to provide a dummy load to the motor driver to enable DCC readback when no motor is connected for development purposes.
Circuit Usage
Most software development can be done without having a motor connected. However, when programming a board via DCC it is supposed to support "readback" where it pulses 60ma of load on the track to indicate acknowledgement. So that the user does not have to connect a motor to develop when JP61 is closed a 100 Ohm resistor is put across the motor output. This allows the board to generate the 60ma pulses, and for readback to function correctly.
Properties
Ref | Name | Value | Unit | Comment
R91 | Ir(steady) | 2 | Amps | Maxium steady state current.
R91 | Ir(pulse) | 10 | Amps | Maximum pulsed current.
R91 | Pr | 2 | Watts | Maximum power dissipation.
R91 | R | 100 | Ω
Validations
Num | Check | TRUE/FALSE |  | Description
1 | Ireadback >= Imin | TRUE |  | Current greater than the project requirement.
2 | Imax < Ir(steady) | TRUE |  | Check that we are in-range with the voltage divider.
3 | P(max) < Pr | FALSE |  | Power dissipation is within in the Resistor's tolerance. See note #1.
Calculations
Num | Parameter | Calaculation | Unit | Description
1 | Imax | 0.300 | Amps | Current @Vdcc(max)
2 | Imin | 0.060 | Amps | Current @Vdcc(min)
3 | P(max) | 9.00 | Watts | Power @Vdcc(max)
4 | P(min) | 0.36 | Watts | Power @Vdcc(min)
5 | Max Supported Voltage | 14.142 | Volts | Maximum track power where 100% throttle will stay within the resistor power limits.
Selections
Ref | Component | Size | Sub | MPN
R91 | 100Ω 2W 5% 2512 | 2512 | N | RC2512JK-7W100RL
Notes
Num
1 | 1. It is not practical to source a resistor that can handle a 100% on duty cycle at maximum track voltage. The goal of this part is to enable DCC readback, which is a series of 60ms pulses, maximum 8 (read back in Direct Mode). Part is safe on Vdrive voltages up to 14.142, which translates to track voltages of 15.342 volts. This should cover the typical N and Z voltage levels on most boosters. The O/G levels with 100% throttle will overdrive the part and damage it. The user must be cautioned.
