bicknell/DCC-Mobile-Decoder/hardware/decoders/Wired-N-1A-2-1/Wired-N-1A-2-1.pdf

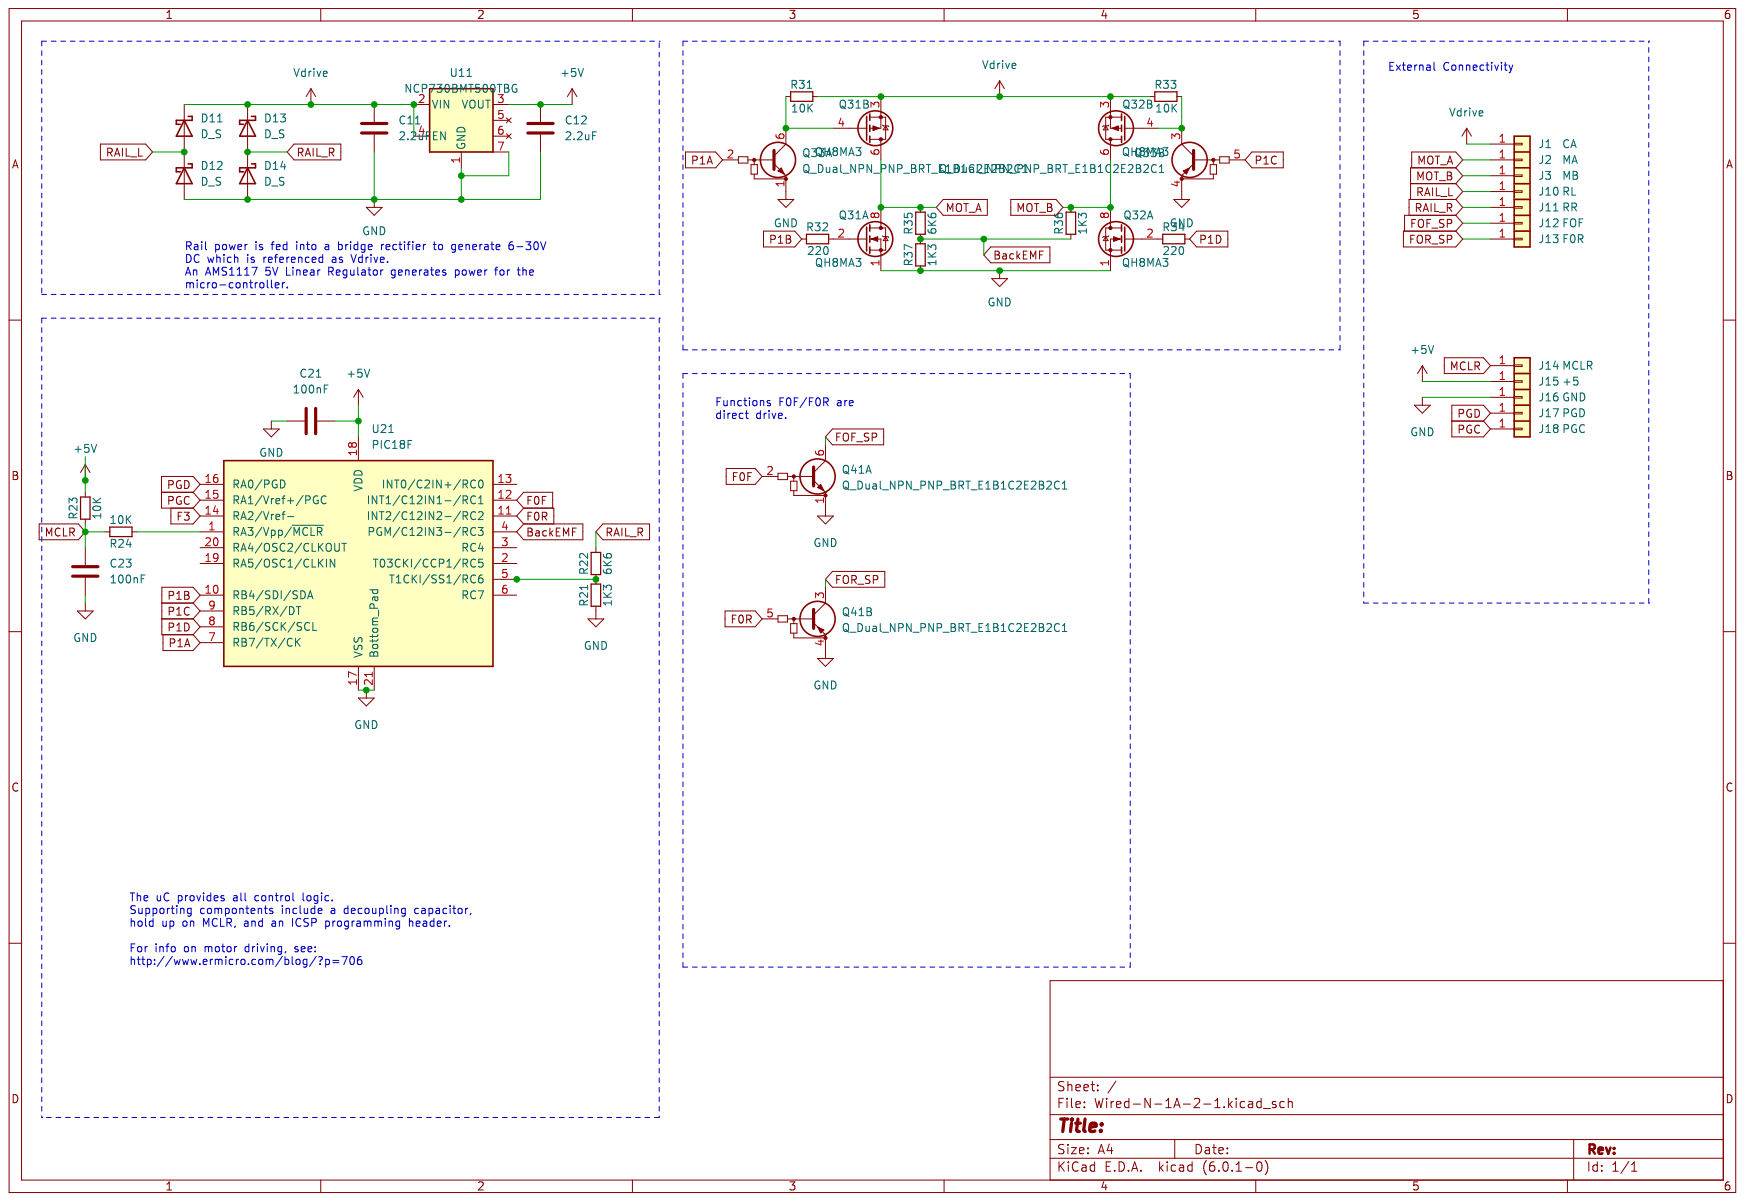
[picture p9: page 1]
