bicknell/DCC-Mobile-Decoder/hardware/decoders/Wired-N-1A-8-1/Wired-N-1A-8-1.pdf

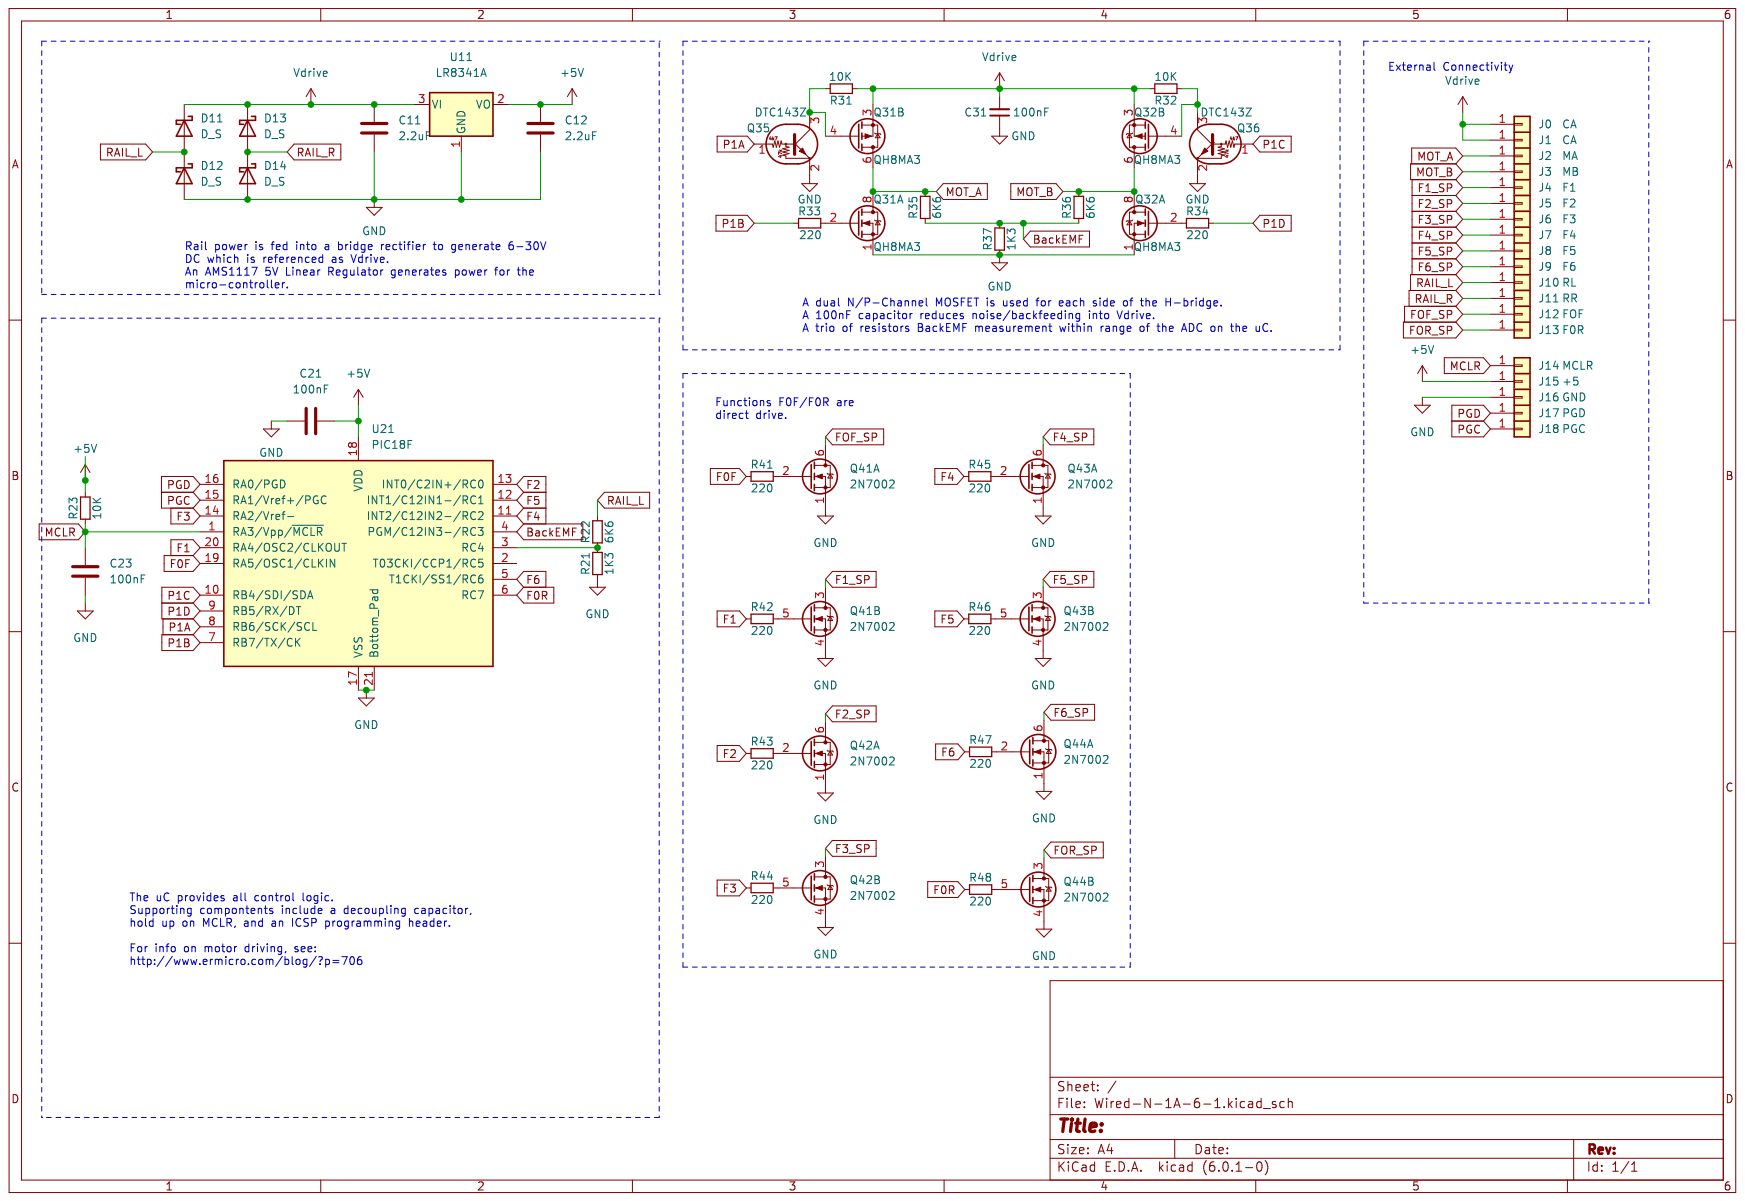
[picture p10: page 1]
