bicknell/DCC-Mobile-Decoder/hardware/reference/Breadboard-2/Breadboard-2.kicad_pcb

## KiCad design hardware/reference/Breadboard-2/Breadboard-2.kicad_pcb (2023-10-22)

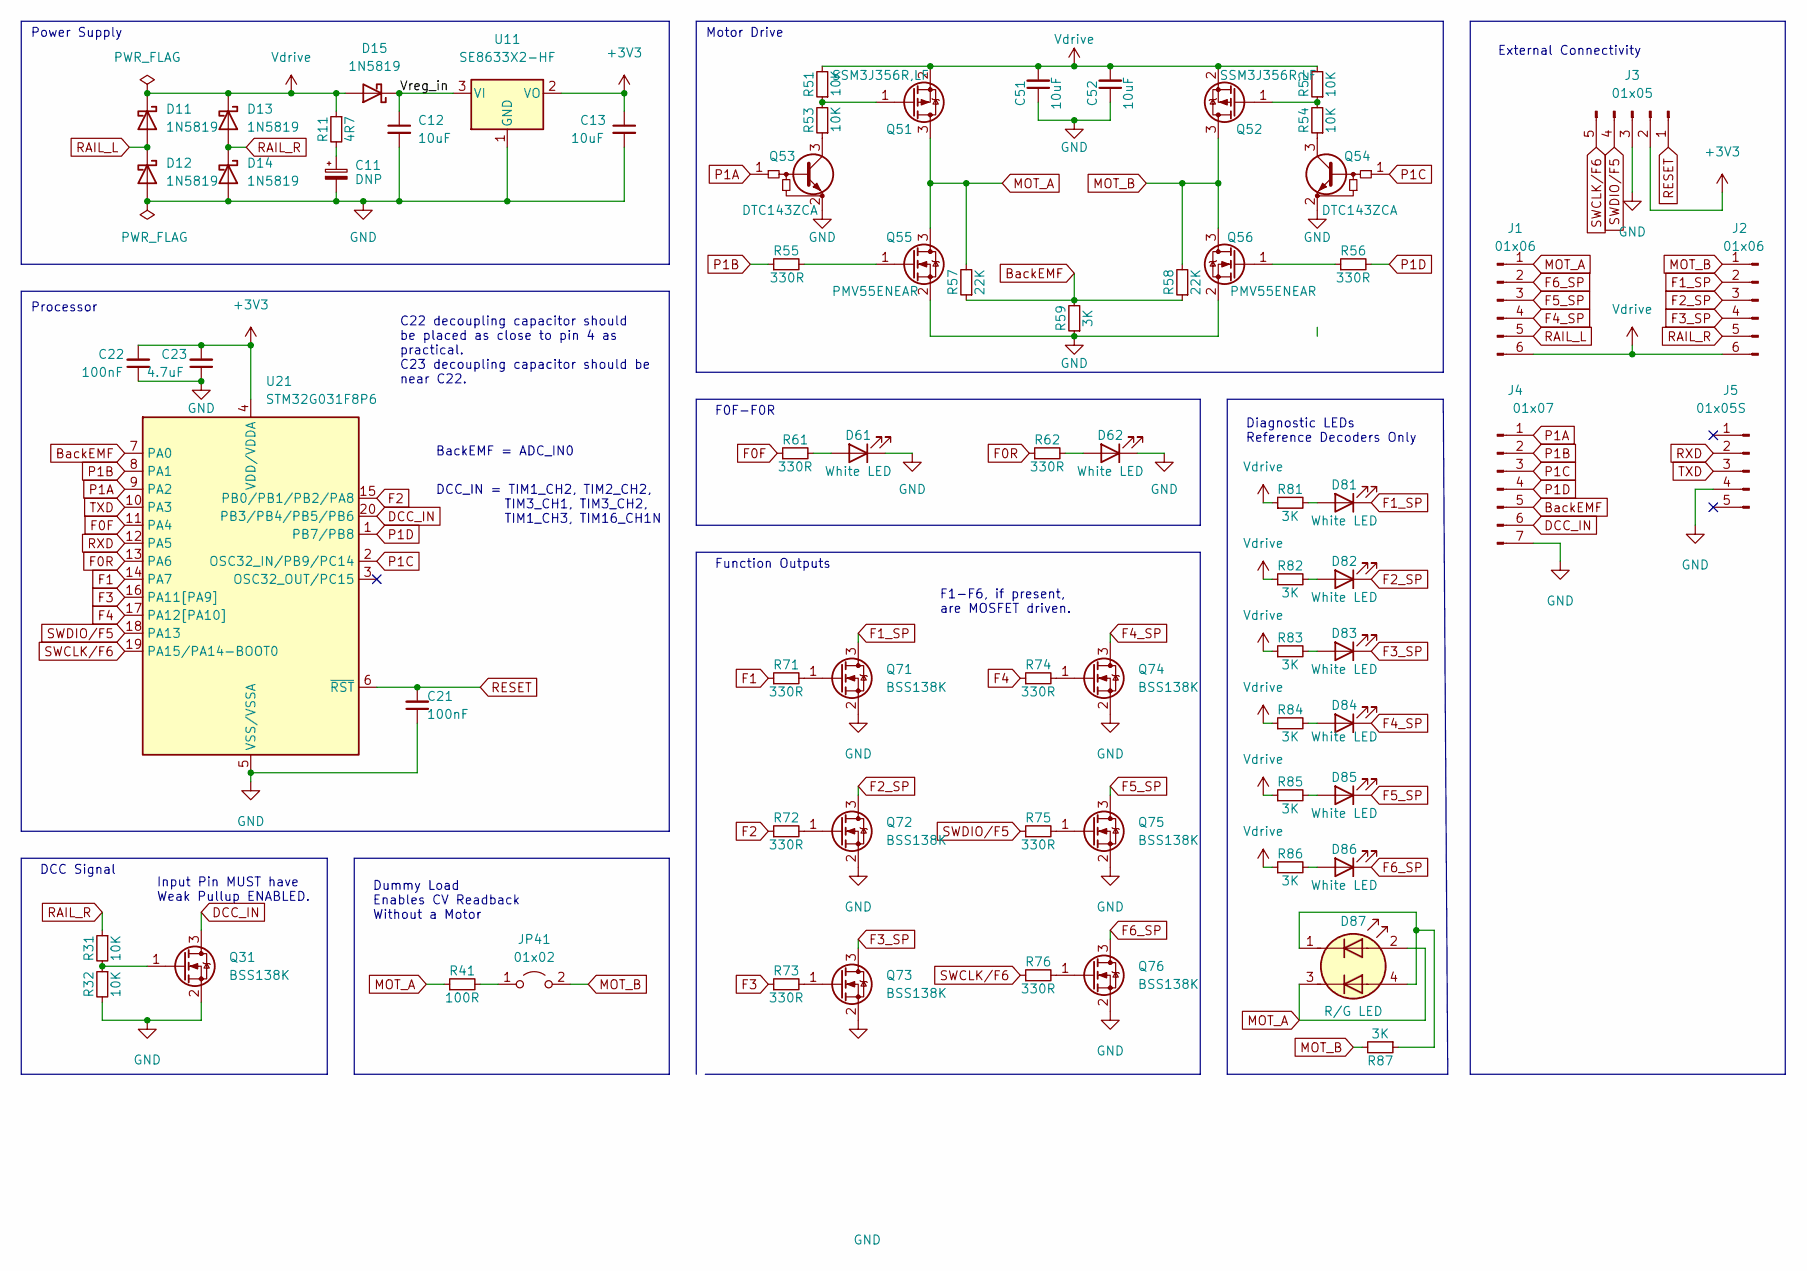
[picture p11: schematic Breadboard-2.kicad_sch]

Parts:
C11: DNP; CP_Radial_D10.0mm_P2.50mm_P5.00mm; MPN DNP; LCSC DNP
C12, C13, C51, C52: 10uF; C_0805_2012Metric; MPN Generic; LCSC C440198
C21, C22: 100nF; C_0805_2012Metric; MPN Generic; LCSC C49678
C23: 4.7uF; C_0805_2012Metric; MPN Generic; LCSC C49678
D11, D12, D13, D14, D15: 1N5819; D_SOD-323; MPN 1N5819WS; LCSC C191023
D61, D62, D81, D82, D83, D84, D85, D86: White LED; LED_0805_2012Metric; MPN KT-0805-W; LCSC C34499
D87: R/G LED; LED_RGB_1210; MPN XL-3227SURSYGC; LCSC C965843
J1, J2: 01x06; PinHeader_1x06_P2.54mm_Vertical; MPN DNP; LCSC DNP
J3: 01x05; PinHeader_1x05_P2.54mm_Horizontal; MPN DNP; LCSC DNP
J4: 01x07; PinHeader_1x07_P2.54mm_Vertical; MPN DNP; LCSC DNP
J5: 01x05S; PinSocket_1x05_P2.54mm_Horizontal; MPN DNP; LCSC DNP
JP41: 01x02; PinHeader_1x02_P2.54mm_Vertical; MPN DNP; LCSC DNP
Q31, Q71, Q72, Q73, Q74, Q75, Q76: BSS138K; SOT-23; MPN BSS138K; LCSC C5224263
Q51, Q52: SSM3J356R,LF; SOT-23; MPN SSM3J356R,LF; LCSC C146306
Q53, Q54: DTC143ZCA; SOT-23; MPN DTC143ZCA; LCSC C15236
Q55, Q56: PMV55ENEAR; SOT-23; MPN PMV55ENEAR; LCSC C294616
R11: 4R7; R_0805_2012Metric; MPN Generic; LCSC C17675
R31, R32, R51, R52, R53, R54: 10K; R_0805_2012Metric; MPN Generic; LCSC C17414
R41: 100R; R_2512_6332Metric; MPN RC2512JK-7W100RL; LCSC C876265
R55, R56, R61, R62, R71, R72, R73, R74, R75, R76: 330R; R_0805_2012Metric; MPN Generic; LCSC C17630
R57, R58: 22K; R_0805_2012Metric; MPN Generic; LCSC C17560
R59, R81, R82, R83, R84, R85, R86, R87: 3K; R_0805_2012Metric; MPN Generic; LCSC C17661
U11: SE8633X2-HF; SOT-23; MPN SE8633X2-HF; LCSC C496613
U21: STM32G031F8P6; TSSOP-20_4.4x6.5mm_P0.65mm; MPN STM32G031F8P6; LCSC C529334

Connections:
+3V3: C13.1, C22.2, C23.2, J3.2, U11.2 (VO), U21.4 (VDD/VDDA)
/Vreg_in: C12.1, D15.1 (K), U11.3 (VI)
BackEMF: J4.5, R57.1, R58.1, R59.2, U21.7 (PA0)
DCC_IN: J4.6, Q31.3 (D), U21.20 (PB3/PB4/PB5/PB6)
F0F: R61.1, U21.11 (PA4)
F0R: R62.1, U21.13 (PA6)
F1: R71.1, U21.14 (PA7)
F1_SP: D81.1 (K), J2.2, Q71.3 (D)
F2: R72.1, U21.15 (PB0/PB1/PB2/PA8)
F2_SP: D82.1 (K), J2.3, Q72.3 (D)
F3: R73.1, U21.16 (PA11[PA9])
F3_SP: D83.1 (K), J2.4, Q73.3 (D)
F4: R74.1, U21.17 (PA12[PA10])
F4_SP: D84.1 (K), J1.4, Q74.3 (D)
F5_SP: D85.1 (K), J1.3, Q75.3 (D)
F6_SP: D86.1 (K), J1.2, Q76.3 (D)
GND: C11.2, C12.2, C13.2, C21.1, C22.1, C23.1, C51.1, C52.1, D12.2 (A), D14.2 (A), D61.1 (K), D62.1 (K), J3.3, J4.7, J5.4, Q31.2 (S), Q53.2 (E), Q54.2 (E), Q55.2 (S), Q56.2 (S), Q71.2 (S), Q72.2 (S), Q73.2 (S), Q74.2 (S), Q75.2 (S), Q76.2 (S), R32.2, R59.1, U11.1 (GND), U21.5 (VSS/VSSA)
MOT_A: D87.2 (K1), D87.3 (A2), J1.1, Q51.3 (D), Q55.3 (D), R41.1, R57.2
MOT_B: J2.1, JP41.2 (B), Q52.3 (D), Q56.3 (D), R58.2, R87.2
unnamed: C11.1, R11.2
unnamed: D61.2 (A), R61.2
unnamed: D62.2 (A), R62.2
unnamed: D81.2 (A), R81.2
unnamed: D82.2 (A), R82.2
unnamed: D83.2 (A), R83.2
unnamed: D84.2 (A), R84.2
unnamed: D85.2 (A), R85.2
unnamed: D86.2 (A), R86.2
unnamed: D87.1 (A1), D87.4 (K2), R87.1
unnamed: JP41.1 (A), R41.2
unnamed: Q31.1 (G), R31.2, R32.1
unnamed: Q51.1 (G), R51.1, R53.2
unnamed: Q52.1 (G), R52.1, R54.2
unnamed: Q53.3 (C), R53.1
unnamed: Q54.3 (C), R54.1
unnamed: Q55.1 (G), R55.2
unnamed: Q56.1 (G), R56.1
unnamed: Q71.1 (G), R71.2
unnamed: Q72.1 (G), R72.2
unnamed: Q73.1 (G), R73.2
unnamed: Q74.1 (G), R74.2
unnamed: Q75.1 (G), R75.2
unnamed: Q76.1 (G), R76.2
P1A: J4.1, Q53.1 (B), U21.9 (PA2)
P1B: J4.2, R55.1, U21.8 (PA1)
P1C: J4.3, Q54.1 (B), U21.2 (OSC32_IN/PB9/PC14)
P1D: J4.4, R56.2, U21.1 (PB7/PB8)
RAIL_L: D11.2 (A), D12.1 (K), J1.5
RAIL_R: D13.2 (A), D14.1 (K), J2.5, R31.1
RESET: C21.2, J3.1, U21.6 (~RST)
RXD: J5.2, U21.12 (PA5)
SWCLK/F6: J3.5, R76.1, U21.19 (PA15/PA14-BOOT0)
SWDIO/F5: J3.4, R75.1, U21.18 (PA13)
TXD: J5.3, U21.10 (PA3)
Vdrive: C51.2, C52.2, D11.1 (K), D13.1 (K), D15.2 (A), J1.6, J2.6, Q51.2 (S), Q52.2 (S), R11.1, R51.2, R52.2, R81.1, R82.1, R83.1, R84.1, R85.1, R86.1

Notes on the sheet:
DCC Signal
F0F-F0R
Input Pin MUST have Weak Pullup ENABLED.
BackEMF = ADC_IN0
Function Outputs
Power Supply
External Connectivity
F1-F6, if present, are MOSFET driven.
Diagnostic LEDs Reference Decoders Only
Motor Drive
DCC_IN = TIM1_CH2, TIM2_CH2, TIM3_CH1, TIM3_CH2, TIM1_CH3, TIM16_CH1N
C22 decoupling capacitor should be placed as close to pin 4 as practical. C23 decoupling capacitor should be near C22.
Processor
Dummy Load Enables CV Readback Without a Motor

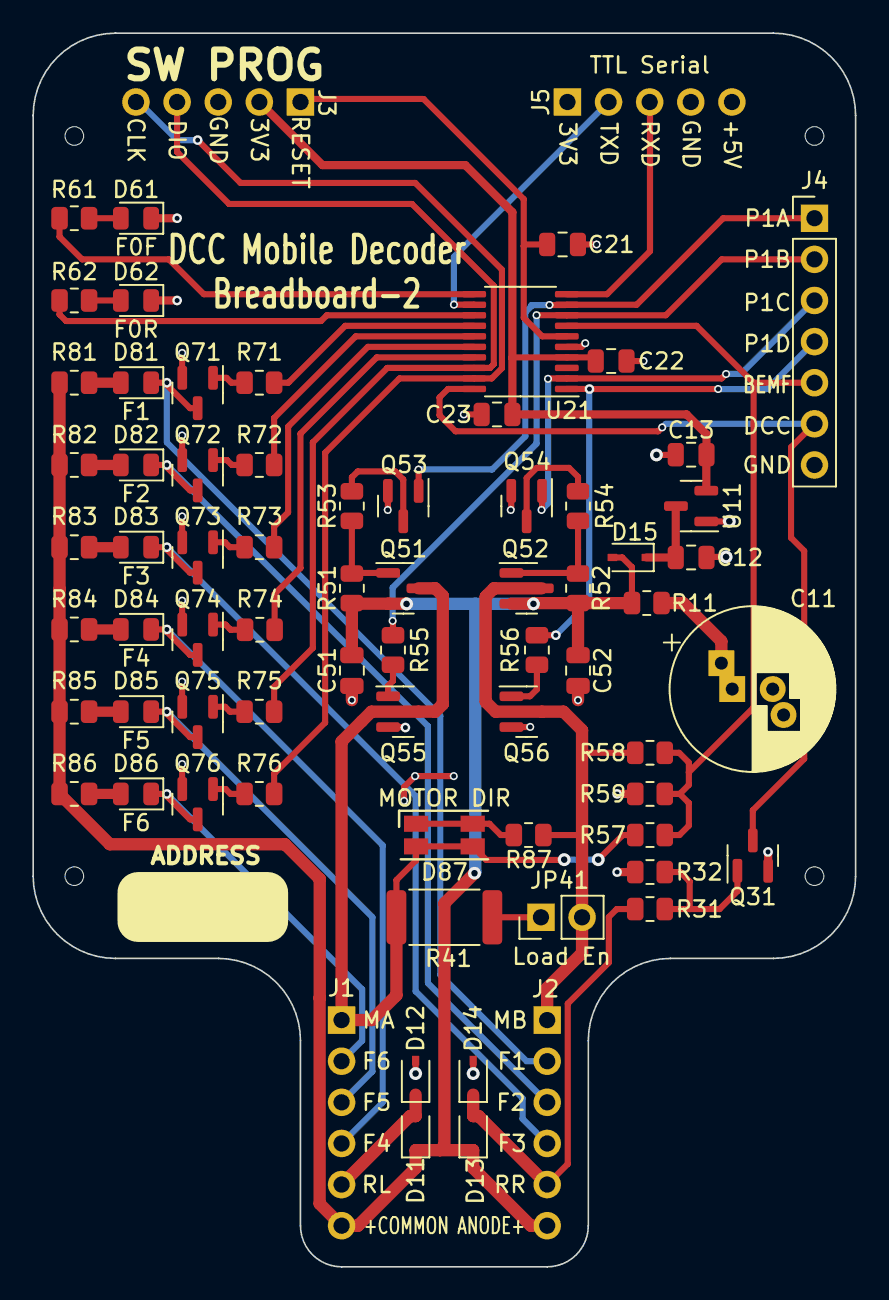
[picture p12: board Breadboard-2.kicad_pcb from above]

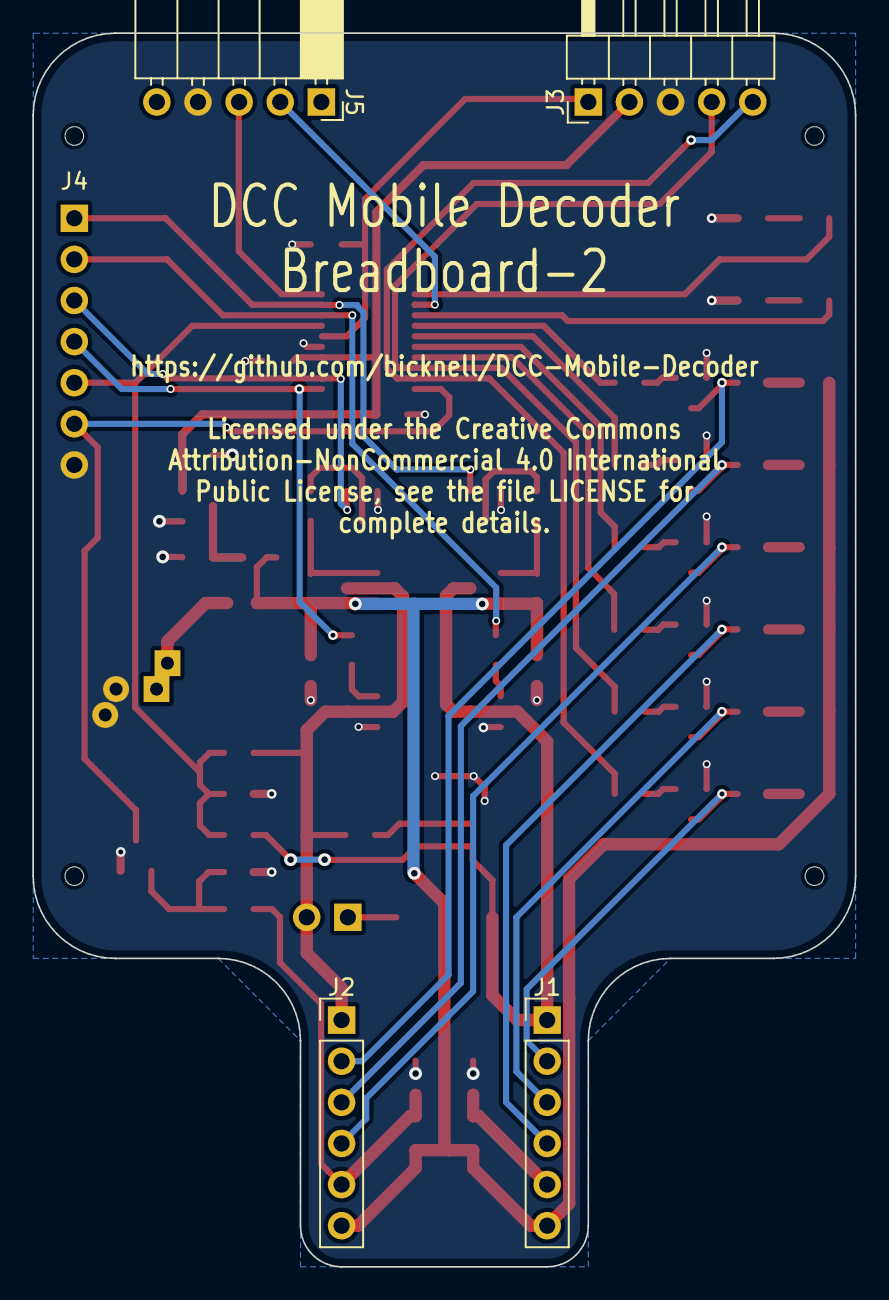
[picture p13: board Breadboard-2.kicad_pcb from below]

Board: 2 copper layers, 50.8 x 76.2 mm, 71 parts (4 on the bottom side), 55 nets.
