bicknell/DCC-Mobile-Decoder/hardware/decoders/Atlas-N-1A-2-GP40-1/Atlas-N-1A-2-GP40-1.kicad_pcb

## KiCad design hardware/decoders/Atlas-N-1A-2-GP40-1/Atlas-N-1A-2-GP40-1.kicad_pcb (2023-10-04)

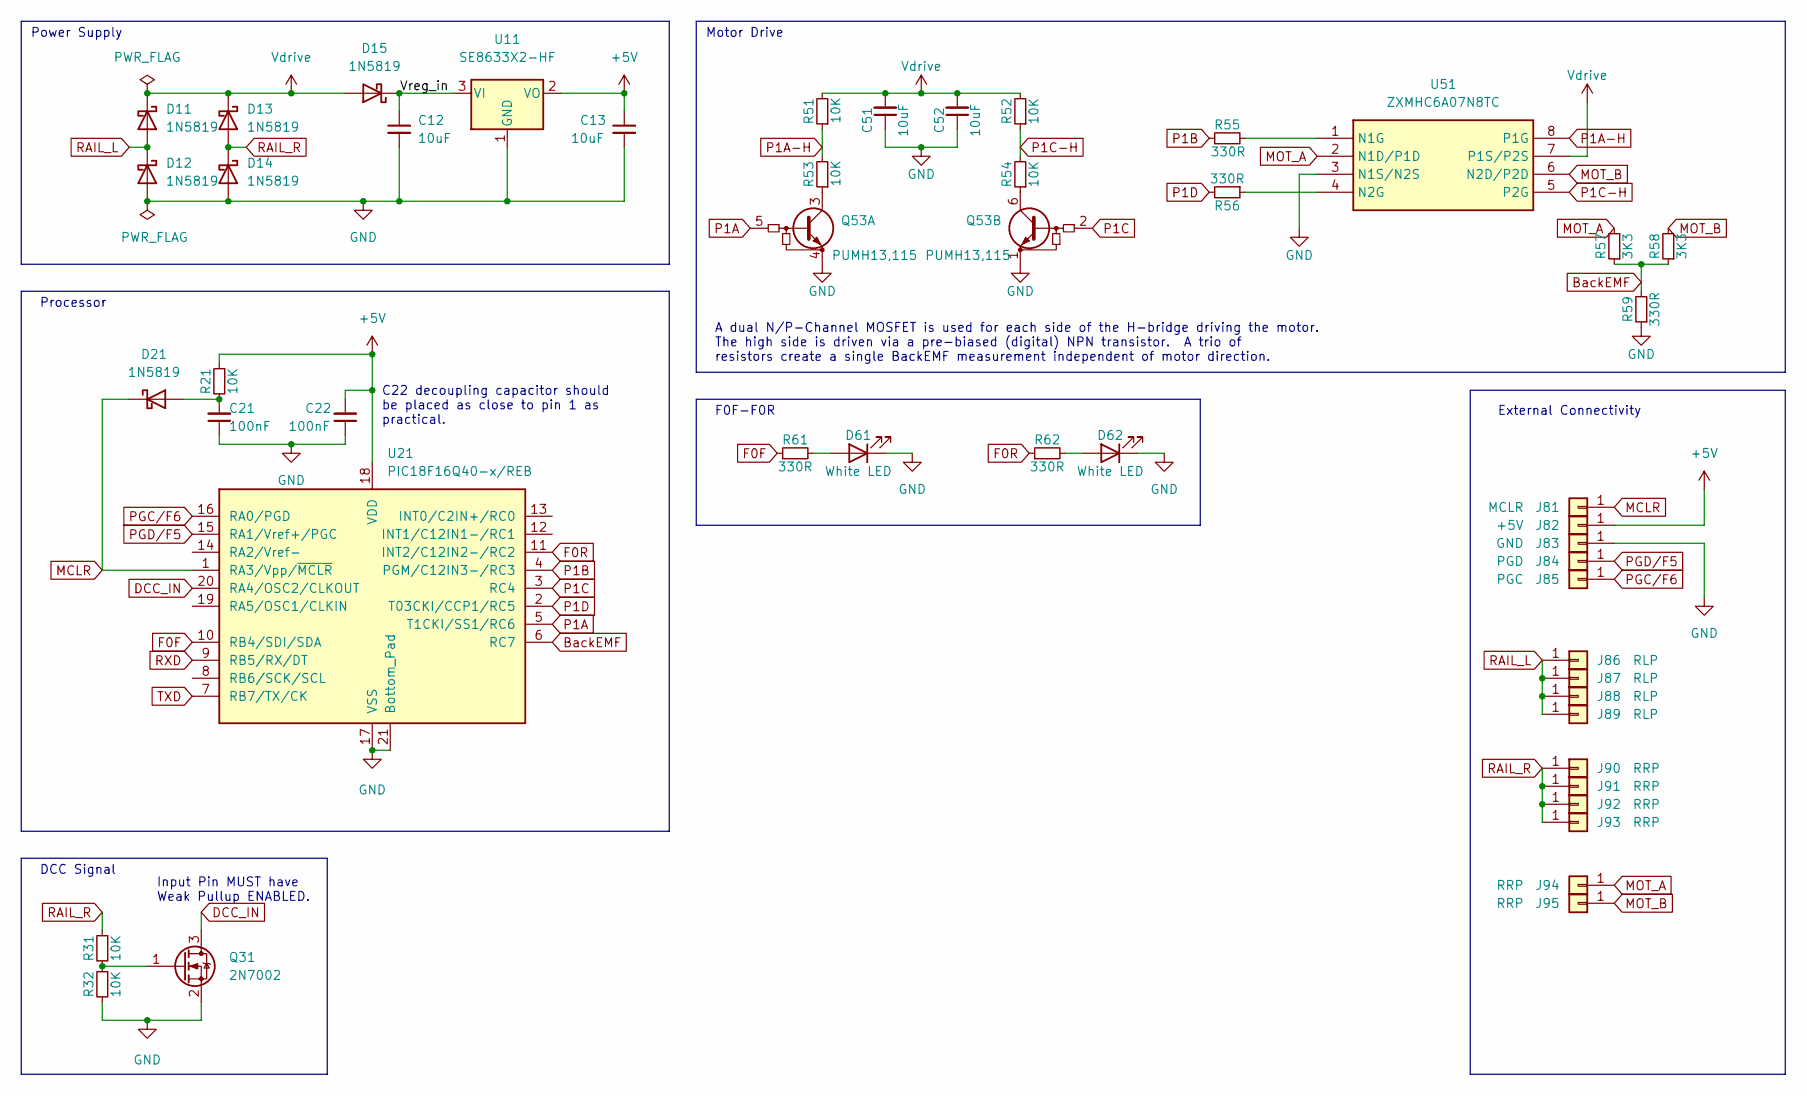
[picture p14: schematic Atlas-N-1A-2-GP40-1.kicad_sch]

Parts:
C12, C13, C51, C52: 10uF; C_0805_2012Metric; MPN GRM21BR61H106KE43L; LCSC C440198
C21, C22: 100nF; C_0402_1005Metric; MPN CL05B104KO5NNNC; LCSC C1525
D11, D12, D13, D14, D15, D21: 1N5819; D_SOD-323; MPN 1N5819WS; LCSC C191023
D61, D62: White LED; LED_0402_1005Metric; MPN KT-0805-W; LCSC C34499
J81: MCLR; EP-1.5mmx3mm; MPN DNP; LCSC DNP
J82: +5V; EP-1.5mmx3mm; MPN DNP; LCSC DNP
J83: GND; EP-1.5mmx3mm; MPN DNP; LCSC DNP
J84: PGD; EP-1.5mmx3mm; MPN DNP; LCSC DNP
J85: PGC; EP-1.5mmx3mm; MPN DNP; LCSC DNP
J86, J87, J88, J89: RLP; EP-1.5mmx3mm; MPN DNP; LCSC DNP
J90, J91, J92, J93: RRP; EP-1.5mmx3mm; MPN DNP; LCSC DNP
J94: RRP; EP-2.5mmx3mm; MPN DNP; LCSC DNP
J95: RRP; EP-2.5mmx5mm; MPN DNP; LCSC DNP
Q31: 2N7002; SOT-23; MPN 2N7002; LCSC C8545
Q53: PUMH13,115; SOT-363_SC-70-6; MPN PUMH13,115; LCSC C426875
R21, R31, R32, R51, R52, R53, R54: 10K; R_0402_1005Metric; MPN 0402WGF1502TCE; LCSC C25744
R55, R56, R59, R61, R62: 330R; R_0402_1005Metric; MPN 0402WGF3300TCE; LCSC C25104
R57, R58: 3K3; R_0402_1005Metric; MPN 0402WGF3301TCE; LCSC C25890
U11: SE8633X2-HF; SOT-23; MPN SE8633X2-HF; LCSC C496613
U21: PIC18F16Q40-x/REB; VQFN-20-1EP_3x3mm_P0.4mm_EP1.7x1.7mm; MPN PIC18F16Q40-I/REB; LCSC C3216898
U51: ZXMHC6A07N8TC; SOIC-8_3.9x4.9mm_P1.27mm; MPN ZXMHC6A07N8TC; LCSC C460274

Connections:
+5V: C13.1, C22.2, J82.1, R21.1, U11.2 (VO), U21.18 (VDD)
/Vreg_in: C12.1, D15.1 (K), U11.3 (VI)
BackEMF: R57.1, R58.1, R59.2, U21.6 (RC7)
DCC_IN: Q31.3 (D), U21.20 (RA4/OSC2/CLKOUT)
F0F: R61.1, U21.10 (RB4/SDI/SDA)
F0R: R62.1, U21.11 (INT2/C12IN2-/RC2)
GND: C12.2, C13.2, C21.1, C22.1, C51.1, C52.1, D12.2 (A), D14.2 (A), D61.1 (K), D62.1 (K), J83.1, Q31.2 (S), Q53.1 (E2), Q53.4 (E1), R32.2, R59.1, U11.1 (GND), U21.17 (VSS), U21.21 (Bottom_Pad), U51.3 (N1S/N2S)
MCLR: D21.1 (K), J81.1, U21.1 (RA3/Vpp/~MCLR)
MOT_A: J94.1, R57.2, U51.2 (N1D/P1D)
MOT_B: J95.1, R58.2, U51.6 (N2D/P2D)
unnamed: C21.2, D21.2 (A), R21.2
unnamed: D61.2 (A), R61.2
unnamed: D62.2 (A), R62.2
unnamed: Q31.1 (G), R31.2, R32.1
unnamed: Q53.3 (C1), R53.1
unnamed: Q53.6 (C2), R54.1
unnamed: R55.2, U51.1 (N1G)
unnamed: R56.1, U51.4 (N2G)
P1A: Q53.5 (B1), U21.5 (T1CKI/SS1/RC6)
P1A-H: R51.1, R53.2, U51.8 (P1G)
P1B: R55.1, U21.4 (PGM/C12IN3-/RC3)
P1C: Q53.2 (B2), U21.3 (RC4)
P1C-H: R52.1, R54.2, U51.5 (P2G)
P1D: R56.2, U21.2 (T03CKI/CCP1/RC5)
PGC/F6: J85.1, U21.16 (RA0/PGD)
PGD/F5: J84.1, U21.15 (RA1/Vref+/PGC)
RAIL_L: D11.2 (A), D12.1 (K), J86.1, J87.1, J88.1, J89.1
RAIL_R: D13.2 (A), D14.1 (K), J90.1, J91.1, J92.1, J93.1, R31.1
RXD: U21.9 (RB5/RX/DT)
TXD: U21.7 (RB7/TX/CK)
Vdrive: C51.2, C52.2, D11.1 (K), D13.1 (K), D15.2 (A), R51.2, R52.2, U51.7 (P1S/P2S)

Notes on the sheet:
DCC Signal
F0F-F0R
Input Pin MUST have Weak Pullup ENABLED.
Power Supply
External Connectivity
Motor Drive
C22 decoupling capacitor should be placed as close to pin 1 as practical.
A dual N/P-Channel MOSFET is used for each side of the H-bridge driving the motor. The high side is driven via a pre-biased (digital) NPN transistor. A trio of resistors create a single BackEMF measurement independent of motor direction.
Processor

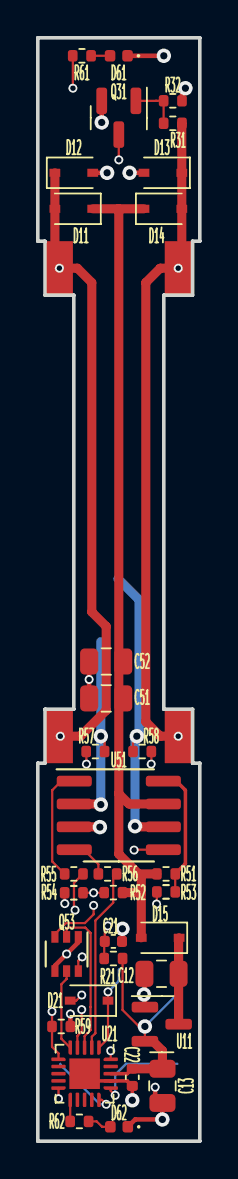
[picture p15: board Atlas-N-1A-2-GP40-1.kicad_pcb from above]

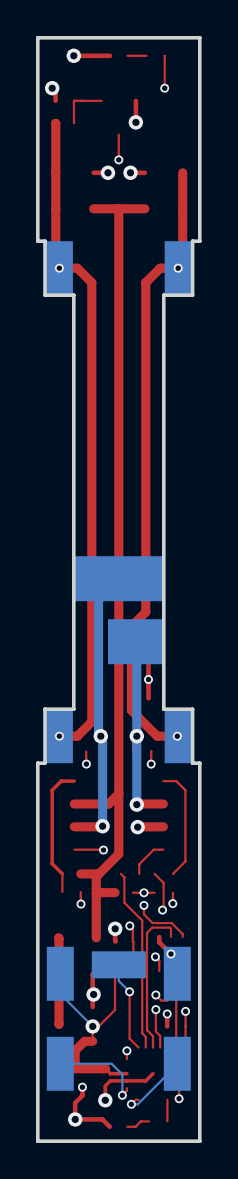
[picture p16: board Atlas-N-1A-2-GP40-1.kicad_pcb from below]

Board: 4 copper layers, 9.0 x 61.3 mm, 48 parts (11 on the bottom side), 29 nets.
