bicknell/DCC-Mobile-Decoder/hardware/decoders/Wired-N-1A-2-1/Wired-N-1A-2-1.kicad_pcb

## KiCad design hardware/decoders/Wired-N-1A-2-1/Wired-N-1A-2-1.kicad_pcb (2023-09-27)

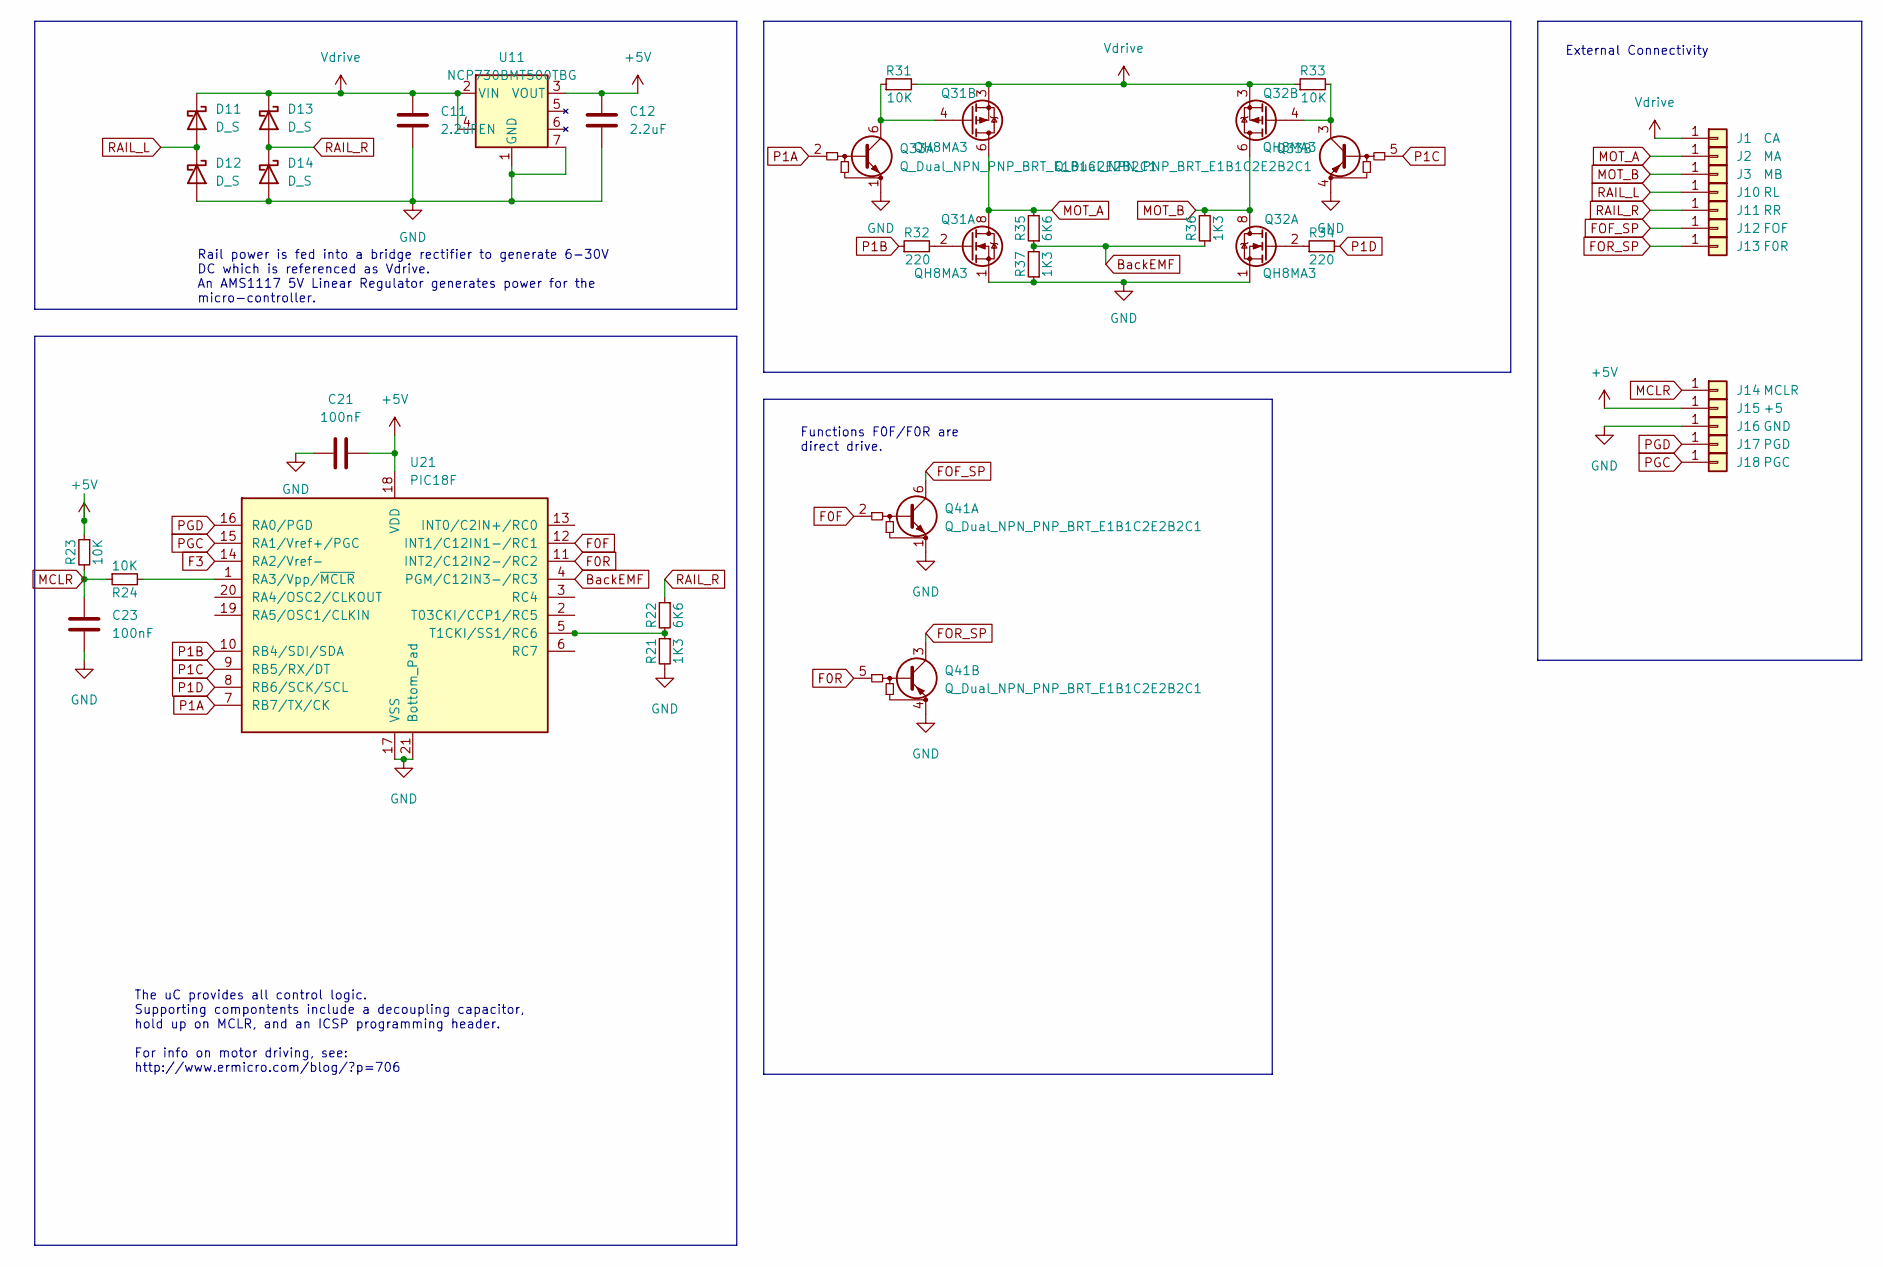
[picture p17: schematic Wired-N-1A-2-1.kicad_sch]

Parts:
C11, C12: 2.2uF; C_0402_1005Metric; MPN1 GRM155R6YA225KE11D
C21, C23: 100nF; C_0201_0603Metric; MPN1 GRM033R61E104KE14D
D11, D12, D13, D14: D_S; D_SOD-523; MPN1 MSK4010
J1: CA; SolderWirePad_1x01_SMD_1x2mm; MPN1 DNP
J2: MA; SolderWirePad_1x01_SMD_1x2mm; MPN1 DNP
J3: MB; SolderWirePad_1x01_SMD_1x2mm; MPN1 DNP
J10: RL; SolderWirePad_1x01_SMD_1x2mm; MPN1 DNP
J11: RR; SolderWirePad_1x01_SMD_1x2mm; MPN1 DNP
J12: FOF; SolderWirePad_1x01_SMD_1x2mm; MPN1 DNP
J13: F0R; SolderWirePad_1x01_SMD_1x2mm; MPN1 DNP
J14: MCLR; SolderWirePad_1x01_SMD_1x2mm; MPN1 DNP
J15: +5; SolderWirePad_1x01_SMD_1x2mm; MPN1 DNP
J16: GND; SolderWirePad_1x01_SMD_1x2mm; MPN1 DNP
J17: PGD; SolderWirePad_1x01_SMD_1x2mm; MPN1 DNP
J18: PGC; SolderWirePad_1x01_SMD_1x2mm; MPN1 DNP
Q31, Q32: QH8MA3; TSMT8; MPN1 QH8MA3 QH8MA3
Q33, Q41: Q_Dual_NPN_PNP_BRT_E1B1C2E2B2C1; SOT-666
R21, R36, R37: 1K3; R_0201_0603Metric; MPN1 0201WMF1331TEE
R22, R35: 6K6; R_0201_0603Metric; MPN1 0201WMF665KTEE
R23, R24: 10K; R_0201_0603Metric; MPN1 0201WMF1002TEE
R31, R33: 10K; R_0201_0603Metric; MPN1 0201WMF2200TEE
R32, R34: 220; R_0201_0603Metric; MPN1 0201WMF2200TEE
U11: NCP730BMT500TBG; DFN-6-1EP_2x2mm_P0.65mm_EP1x1.6mm; MPN1 NCP730BMT500TBG
U21: PIC18F; VQFN-20-1EP_3x3mm_P0.4mm_EP1.7x1.7mm; MPN1 PIC18F06Q40

Connections:
+5V: C12.1, C21.2, J15.1, R23.1, U11.3 (VOUT), U21.18 (VDD)
BackEMF: R35.1, R36.1, R37.2, U21.4 (PGM/C12IN3-/RC3)
F0F: Q41.2 (B1), U21.12 (INT1/C12IN1-/RC1)
F0R: Q41.5 (B1), U21.11 (INT2/C12IN2-/RC2)
F3: U21.14 (RA2/Vref-)
FOF_SP: J12.1, Q41.6 (C1)
FOR_SP: J13.1, Q41.3 (C1)
GND: C11.2, C12.2, C21.1, C23.1, D12.2 (A), D14.2 (A), J16.1, Q31.1 (S), Q32.1 (S), Q33.1 (E1), Q33.4 (E1), Q41.1 (E1), Q41.4 (E1), R21.2, R37.1, U11.1 (GND), U11.7, U21.17 (VSS), U21.21 (Bottom_Pad)
MCLR: C23.2, J14.1, R23.2, R24.1
MOT_A: J2.1, Q31.5 (D), Q31.6 (D), Q31.7 (D), Q31.8 (D), R35.2
MOT_B: J3.1, Q32.5 (D), Q32.6 (D), Q32.7 (D), Q32.8 (D), R36.2
unnamed: Q31.2 (G), R32.2
unnamed: Q31.4 (G), Q33.6 (C1), R31.1
unnamed: Q32.2 (G), R34.1
unnamed: Q32.4 (G), Q33.3 (C1), R33.2
unnamed: R21.1, R22.2, U21.5 (T1CKI/SS1/RC6)
unnamed: R24.2, U21.1 (RA3/Vpp/~MCLR)
P1A: Q33.2 (B1), U21.7 (RB7/TX/CK)
P1B: R32.1, U21.10 (RB4/SDI/SDA)
P1C: Q33.5 (B1), U21.9 (RB5/RX/DT)
P1D: R34.2, U21.8 (RB6/SCK/SCL)
PGC: J18.1, U21.15 (RA1/Vref+/PGC)
PGD: J17.1, U21.16 (RA0/PGD)
RAIL_L: D11.2 (A), D12.1 (K), J10.1
RAIL_R: D13.2 (A), D14.1 (K), J11.1, R22.1
Vdrive: C11.1, D11.1 (K), D13.1 (K), J1.1, Q31.3 (1), Q32.3 (1), R31.2, R33.1, U11.2 (VIN), U11.4 (EN)

Notes on the sheet:
External Connectivity
The uC provides all control logic. Supporting compontents include a decoupling capacitor, hold up on MCLR, and an ICSP programming header. For info on motor driving, see: http://www.ermicro.com/blog/?p=706
Functions F0F/F0R are direct drive.
Rail power is fed into a bridge rectifier to generate 6-30V DC which is referenced as Vdrive. An AMS1117 5V Linear Regulator generates power for the micro-controller.

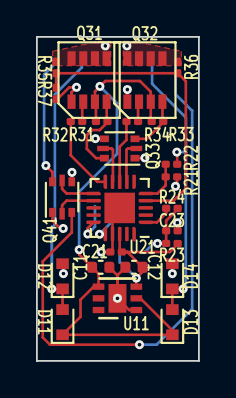
[picture p18: board Wired-N-1A-2-1.kicad_pcb from above]

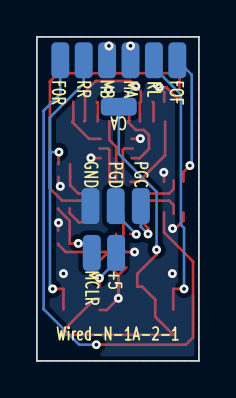
[picture p19: board Wired-N-1A-2-1.kicad_pcb from below]

Board: 2 copper layers, 9.0 x 18.0 mm, 37 parts (12 on the bottom side), 25 nets.
