bicknell/DCC-Mobile-Decoder/hardware/decoders/Wired-N-1A-8-1/Wired-N-1A-8-1.kicad_pcb

## KiCad design hardware/decoders/Wired-N-1A-8-1/Wired-N-1A-8-1.kicad_pcb (2023-09-11)

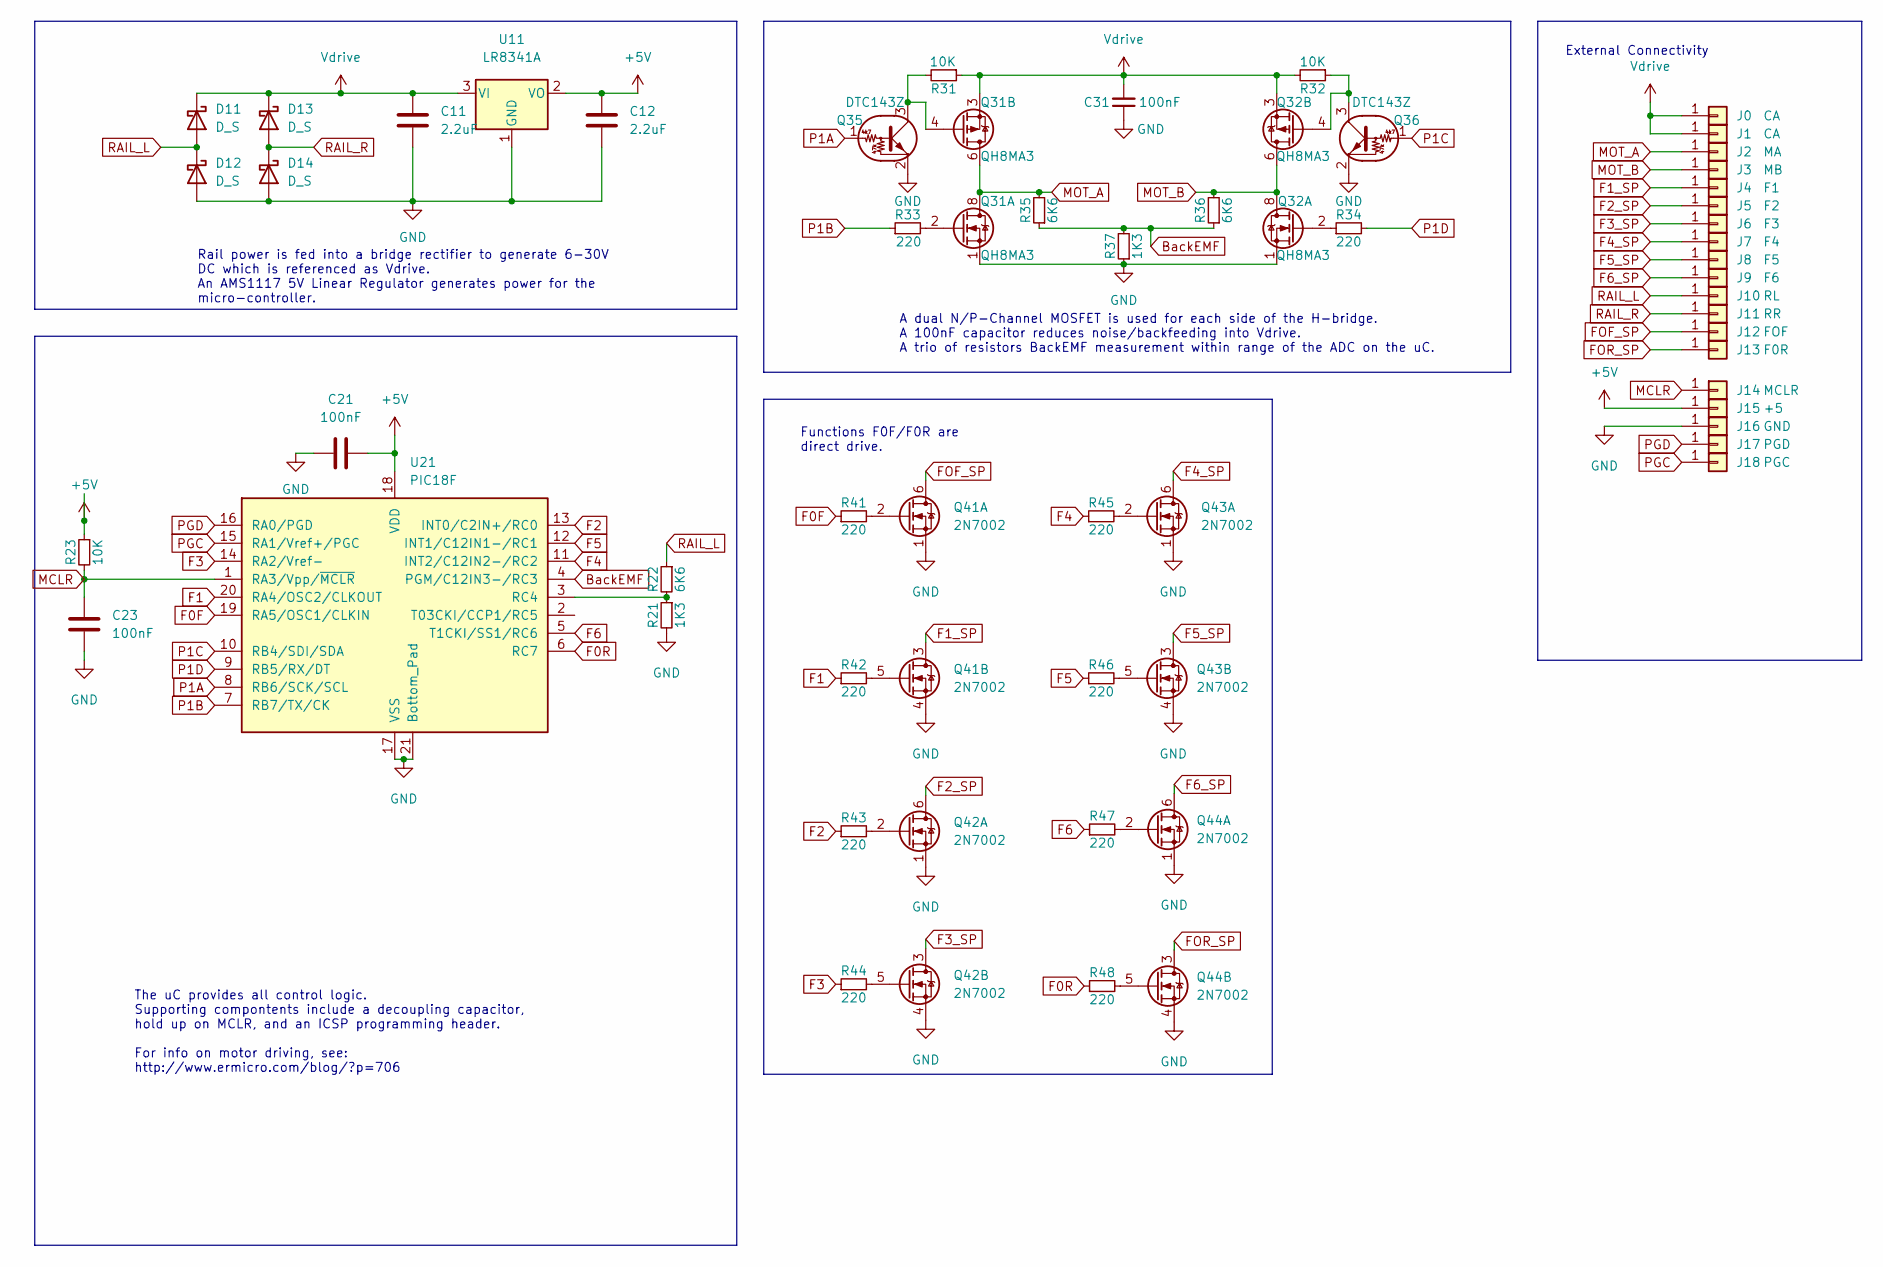
[picture p20: schematic Wired-N-1A-8-1.kicad_sch]

Parts:
C11, C12: 2.2uF; C_0402_1005Metric; MPN1 GRM155R6YA225KE11D
C21, C23: 100nF; C_0201_0603Metric; MPN1 GRM033R61E104KE14D
C31: 100nF; C_0402_1005Metric; MPN1 GRM155R61H104KE14D
D11, D12, D13, D14: D_S; D_SOD-523; MPN1 MSK4010
J0, J1: CA; SolderWirePad_1x01_SMD_1x2mm; MPN1 DNP
J2: MA; SolderWirePad_1x01_SMD_1x2mm; MPN1 DNP
J3: MB; SolderWirePad_1x01_SMD_1x2mm; MPN1 DNP
J4: F1; SolderWirePad_1x01_SMD_1x2mm; MPN1 DNP
J5: F2; SolderWirePad_1x01_SMD_1x2mm; MPN1 DNP
J6: F3; SolderWirePad_1x01_SMD_1x2mm; MPN1 DNP
J7: F4; SolderWirePad_1x01_SMD_1x2mm; MPN1 DNP
J8: F5; SolderWirePad_1x01_SMD_1x2mm; MPN1 DNP
J9: F6; SolderWirePad_1x01_SMD_1x2mm; MPN1 DNP
J10: RL; SolderWirePad_1x01_SMD_1x2mm; MPN1 DNP
J11: RR; SolderWirePad_1x01_SMD_1x2mm; MPN1 DNP
J12: FOF; SolderWirePad_1x01_SMD_1x2mm; MPN1 DNP
J13: F0R; SolderWirePad_1x01_SMD_1x2mm; MPN1 DNP
J14: MCLR; SolderWirePad_1x01_SMD_1x2mm; MPN1 DNP
J15: +5; SolderWirePad_1x01_SMD_1x2mm; MPN1 DNP
J16: GND; SolderWirePad_1x01_SMD_1x2mm; MPN1 DNP
J17: PGD; SolderWirePad_1x01_SMD_1x2mm; MPN1 DNP
J18: PGC; SolderWirePad_1x01_SMD_1x2mm; MPN1 DNP
Q31, Q32: QH8MA3; TSMT8; MPN1 QH8MA3 QH8MA3
Q35, Q36: DTC143Z; SOT-723; MPN1 DTC143ZM
Q41, Q42, Q43, Q44: 2N7002; SOT-363_SC-70-6; MPN1 2N7002KD
R21, R37: 1K3; R_0201_0603Metric; MPN1 0201WMF1331TEE
R22, R35, R36: 6K6; R_0201_0603Metric; MPN1 0201WMF665KTEE
R23: 10K; R_0201_0603Metric; MPN1 0201WMF1002TEE
R31, R32: 10K; R_0201_0603Metric; MPN1 0201WMF2200TEE
R33, R34, R41, R42, R43, R44, R45, R46, R47, R48: 220; R_0201_0603Metric; MPN1 0201WMF2200TEE
U11: LR8341A; SOT-23; MPN1 LR8341A-T50
U21: PIC18F; VQFN-20-1EP_3x3mm_P0.4mm_EP1.7x1.7mm; MPN1 PIC18F06Q40

Connections:
+5V: C12.1, C21.2, J15.1, R23.1, U11.2 (VO), U21.18 (VDD)
BackEMF: R35.1, R36.1, R37.2, U21.4 (PGM/C12IN3-/RC3)
F0F: R41.1, U21.19 (RA5/OSC1/CLKIN)
F0R: R48.1, U21.6 (RC7)
F1: R42.1, U21.20 (RA4/OSC2/CLKOUT)
F1_SP: J4.1, Q41.3 (D)
F2: R43.1, U21.13 (INT0/C2IN+/RC0)
F2_SP: J5.1, Q42.6 (D)
F3: R44.1, U21.14 (RA2/Vref-)
F3_SP: J6.1, Q42.3 (D)
F4: R45.1, U21.11 (INT2/C12IN2-/RC2)
F4_SP: J7.1, Q43.6 (D)
F5: R46.1, U21.12 (INT1/C12IN1-/RC1)
F5_SP: J8.1, Q43.3 (D)
F6: R47.1, U21.5 (T1CKI/SS1/RC6)
F6_SP: J9.1, Q44.6 (D)
FOF_SP: J12.1, Q41.6 (D)
FOR_SP: J13.1, Q44.3 (D)
GND: C11.2, C12.2, C21.1, C23.1, C31.1, D12.2 (A), D14.2 (A), J16.1, Q31.1 (S), Q32.1 (S), Q35.2 (E), Q36.2 (E), Q41.1 (S), Q41.4 (S), Q42.1 (S), Q42.4 (S), Q43.1 (S), Q43.4 (S), Q44.1 (S), Q44.4 (S), R21.2, R37.1, U11.1 (GND), U21.17 (VSS), U21.21 (Bottom_Pad)
MCLR: C23.2, J14.1, R23.2, U21.1 (RA3/Vpp/~MCLR)
MOT_A: J2.1, Q31.5 (D), Q31.6 (D), Q31.7 (D), Q31.8 (D), R35.2
MOT_B: J3.1, Q32.5 (D), Q32.6 (D), Q32.7 (D), Q32.8 (D), R36.2
unnamed: Q31.2 (G), R33.2
unnamed: Q32.2 (G), R34.1
unnamed: Q31.4 (G), Q35.3 (C), R31.2
unnamed: Q41.2 (G), R41.2
unnamed: Q41.5 (G), R42.2
unnamed: Q42.2 (G), R43.2
unnamed: Q42.5 (G), R44.2
unnamed: Q43.2 (G), R45.2
unnamed: Q43.5 (G), R46.2
unnamed: Q44.2 (G), R47.2
unnamed: Q44.5 (G), R48.2
unnamed: R21.1, R22.2, U21.3 (RC4)
unnamed: Q32.4 (G), Q36.3 (C), R32.1
P1A: Q35.1 (B), U21.8 (RB6/SCK/SCL)
P1B: R33.1, U21.7 (RB7/TX/CK)
P1C: Q36.1 (B), U21.10 (RB4/SDI/SDA)
P1D: R34.2, U21.9 (RB5/RX/DT)
PGC: J18.1, U21.15 (RA1/Vref+/PGC)
PGD: J17.1, U21.16 (RA0/PGD)
RAIL_L: D11.2 (A), D12.1 (K), J10.1, R22.1
RAIL_R: D13.2 (A), D14.1 (K), J11.1
Vdrive: C11.1, C31.2, D11.1 (K), D13.1 (K), J0.1, J1.1, Q31.3 (1), Q32.3 (1), R31.1, R32.2, U11.3 (VI)

Notes on the sheet:
External Connectivity
The uC provides all control logic. Supporting compontents include a decoupling capacitor, hold up on MCLR, and an ICSP programming header. For info on motor driving, see: http://www.ermicro.com/blog/?p=706
A dual N/P-Channel MOSFET is used for each side of the H-bridge. A 100nF capacitor reduces noise/backfeeding into Vdrive. A trio of resistors BackEMF measurement within range of the ADC on the uC.
Functions F0F/F0R are direct drive.
Rail power is fed into a bridge rectifier to generate 6-30V DC which is referenced as Vdrive. An AMS1117 5V Linear Regulator generates power for the micro-controller.

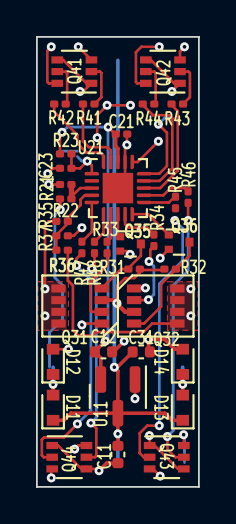
[picture p21: board Wired-N-1A-8-1.kicad_pcb from above]

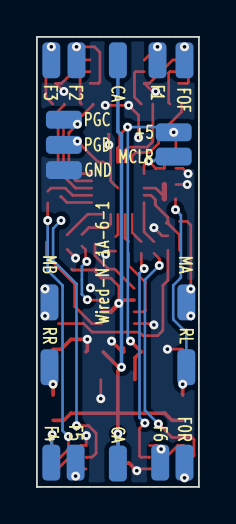
[picture p22: board Wired-N-1A-8-1.kicad_pcb from below]

Board: 2 copper layers, 9.0 x 25.0 mm, 56 parts (19 on the bottom side), 44 nets.
