bicknell/DCC-Mobile-Decoder/software/reference/Breadboard-2/Core/Src/main.c

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
/* Includes ------------------------------------------------------------------*/
#include "main.h"

/* USER CODE BEGIN Includes */
#include <stdio.h>
#include "dcc.h"
#include "cv.h"
/* USER CODE END Includes */

TIM_HandleTypeDef htim1;
TIM_HandleTypeDef htim2;

UART_HandleTypeDef huart2;

/* USER CODE BEGIN PV */
uint32_t counter;

/* USER CODE END PV */

void SystemClock_Config(void);
static void MX_GPIO_Init(void);
static void MX_TIM1_Init(void);
static void MX_USART2_UART_Init(void);
static void MX_TIM2_Init(void);
/* USER CODE BEGIN PFP */
#define PUTCHAR_PROTOTYPE int __io_putchar(int ch)
/* USER CODE END PFP */

/**
  * @brief  The application entry point.
  * @retval int
  */
int main(void)
{
  /* MCU Configuration--------------------------------------------------------*/

  /* Reset of all peripherals, Initializes the Flash interface and the Systick. */
  HAL_Init();

  /* Configure the system clock */
  SystemClock_Config();

  /* Initialize all configured peripherals */
  MX_GPIO_Init();
  MX_TIM1_Init();
  MX_USART2_UART_Init();
  MX_TIM2_Init();
  /* USER CODE BEGIN 2 */

#if DEBUG_STATUS
    printf("\r\nCompiled on %s at %s using version %s with flags 0x%04X.\r\n",
           __DATE__, __TIME__, __VERSION__, __OPTIMIZE__);
#endif

  // Make sure the EEPROM data has been configured.
  cv_check();

  // Initialize the DCC subsystem based on the CV's configured.
  dcc_initialize();

  // Start timers.
  HAL_TIM_Base_Start_IT(&htim1);
  HAL_TIM_Base_Start(&htim2);

  /* USER CODE END 2 */

  /* Infinite loop */
  /* USER CODE BEGIN WHILE */
	while (1) {
    /* USER CODE END WHILE */

    /* USER CODE BEGIN 3 */

		__HAL_TIM_SET_COUNTER(&htim2, 0);

        // Loop until TMR2 goes off.
        while(__HAL_TIM_GET_COUNTER(&htim2) < 25) {
            // Did a DCC packet come in?
            if (dcc_ready) {
                dcc_decode();
                // Tell the ISR we've consumed the message and it can store another.
                dcc_ready = 0;
            } else {
                // Is there anything to do during idle time?
                dcc_idle();
            }
        }
        // Control reaches here when TMR0 has gone off.
        // Perform periodic functions every 25ms.
        dcc_periodic();
        //function_periodic(); // Perform animations for functions.
	}
  /* USER CODE END 3 */
}

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
/* USER CODE BEGIN 4 */

/**
  * @brief  Timer Callback Handler
  * @param  htim: Timer that has been triggered.
  * @retval None
  */
void HAL_TIM_PeriodElapsedCallback(TIM_HandleTypeDef *htim)
{
  /* Timer 1 is our DCC input timer. */
  if (htim == &htim1 )
  {
	DCC_ISR();
  }
}

/**
  * @brief  Retargets the C library printf function to the USART.
  * @param  None
  * @retval None
  */
PUTCHAR_PROTOTYPE
{
  /* Place your implementation of fputc here */
  /* e.g. write a character to the USART1 and Loop until the end of transmission */
  HAL_UART_Transmit(&huart2, (uint8_t *)&ch, 1, 0xFFFF);

  return ch;
}

/* USER CODE END 4 */
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
