bicknell/DCC-Mobile-Decoder/software/reference/Breadboard-2/Breadboard-2.ioc

Mcu.UserName=STM32F103RBTx
PA12.GPIO_Label=DCC_IN
PA12.Signal=S_TIM1_ETR
PA13.Signal=SYS_JTMS-SWDIO
PA14.Signal=SYS_JTCK-SWCLK
PA2.Signal=USART2_TX
PA3.Signal=USART2_RX
PA5.GPIO_Label=STATUS_LED
PA5.Signal=GPIO_Output
