bicknell/DCC-Mobile-Decoder/software/reference/Breadboard-2/Core/Inc/main.h

#define STATUS_LED_Pin GPIO_PIN_5
#define STATUS_LED_GPIO_Port GPIOA
#define DCC_IN_Pin GPIO_PIN_12
#define DCC_IN_GPIO_Port GPIOA
