bicknell/DCC-Mobile-Decoder/(commit log)

2022-11-11 Ignore KiCAD temporary files.
2022-11-11 Initial reference design PCB commit.
    [Breadboard-1.kicad_pcb, Breadboard-1.kicad_sch]
2022-11-11 Initial version of reference decoder.
    [Breadboard-1.kicad_pcb, Breadboard-1.kicad_sch]
2022-11-11 Cleaned up the PCB routing.
    [Breadboard-1.kicad_pcb, Breadboard-1.kicad_sch]
2022-11-11 Initial description of the schematic and PCB.
2022-11-12 Change from +12v to Vdrive.
    [Breadboard-1.kicad_sch]
2022-11-13 Update data sheet values and calculations. Add missing components.
    [Breadboard-1.kicad_pcb, Breadboard-1.kicad_sch]
2022-11-13 Added data sheets. Moved schematic values for readability.
    [Breadboard-1.kicad_sch]
2022-11-13 Lots of cleanup, finalizing the specifications for Breadboard-1.
    [Breadboard-1.kicad_sch]
2022-11-13 Added resistor and capacitor data.
2022-11-13 Added location to write the DCC address on the board.
    [Breadboard-1.kicad_pcb]
2022-11-13 Added MOSFET specifications.
2022-11-13 Minor corrections to the overview document. Refill PCB.
    [Breadboard-1.kicad_pcb]
2022-11-24 Add a 3D render of the board.
2022-11-24 Added V3V3USB capacitor and USB Micro-B port for debugging.
    [Breadboard-1.kicad_pcb, Breadboard-1.kicad_sch]
2022-11-24 Move USB to the External Connectivity section.
    [Breadboard-1.kicad_pcb, Breadboard-1.kicad_sch]
2022-11-24 Update notes to be more clear about circuit design.
    [Breadboard-1.kicad_sch]
2022-11-24 Regenerate image to match current schematic.
2022-11-24 Make functions symmetrical.
    [Breadboard-1.kicad_pcb]
2022-11-28 Initial version of a mobile decoder.
    [Wired-N-1A-6-1.kicad_pcb, Wired-N-1A-6-1.kicad_sch]
2022-12-01 Made Wired-N-1A-6-1 prettier, and easier to follow.
    [Wired-N-1A-6-1.kicad_pcb, Wired-N-1A-6-1.kicad_sch]
2022-12-01 Moved to SOD-123 diodes for cheaper, better rating parts.
    [Breadboard-1.kicad_pcb, Breadboard-1.kicad_sch]
2022-12-08 Chip selection update, new symbols, improved reference design.
    Updated the chip selection document based on availability.
    Added new symbols for the chips in the chip selection document.
    Switched the reference design to an SSOP-20 package and improved the
    layout in general.
    [Breadboard-1.kicad_pcb, Breadboard-1.kicad_sch]
2022-12-08 Updated to the new processor and lots of board layout cleanup.
    [Breadboard-1.kicad_pcb, Breadboard-1.kicad_sch]
2022-12-12 Updating the current project status.
2022-12-12 Position cleanup, better trace routing.
    [Breadboard-1.kicad_pcb, Breadboard-1.kicad_sch]
2022-12-12 Image to match the latest board.
2022-12-13 Add a PDF version of the schematic.
2022-12-13 Fixed broadcast decoder reset packet handling.
    Ran "make clean" before comitting, which is removing all of the build
    artifacts.
    Regenerated MCC files.
    [dcc.c]
2022-12-13 Implement suggestions from DCC-EX friends.
    Set TMR2 period to 80us.
    Implemented consist address feature.
    Move variables out of dcc_decode and into globals for performance.
    Moved checksum inside dcc_decode to make interface cleaner.
    Reordered logic to check the speed/direction packets first, and the
    function group packets second to improve performance.
    Changed logic to not subtract checksum bit so my description of the number
    of bytes in the message matches the NMRA docs. Probably more comments to update
    before this is complete.
    Moved DCC forward and reverse to be a binary bit with constants.
    Filled in a number of the TODOs with debug messages at least.
    Updated motor control to handl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
    [dcc.c, dcc.h, debug.h, hardware.c, hardware.h, main.c]
2022-12-13 Properly implement C19 consisting, including function mapping by CV21/CV22.
    Clean up some bad printf's with extra arguments.
    Improve NDOT (and consisted NDOT) handling in motor_control.
2022-12-14 Fix digital decoder reset logic.
    [dcc.c]
2022-12-16 Clarified the current state of the project.
2022-12-17 Initial version of a fully manual breadboard version of the circuit.
2022-12-17 Initial version of Manual-1.
    [Manual-1.kicad_sch]
2022-12-17 Minor tweak to BOM.
    [Manual-1.kicad_sch]
2022-12-19 Added a 100 Ohm load to enable readback when no motor is connected.
    [Breadboard-1.kicad_pcb, Breadboard-1.kicad_sch]
2022-12-20 Reset handling improvement, fixed bit logic, cleaned Page/Register code.
    [cv.c, dcc.c]
2022-12-22 Add pre-biased transistors to drive high side. Update LED part to more common.
    [Breadboard-1.kicad_pcb, Breadboard-1.kicad_sch]
2022-12-22 Updated schematic PDF based on last edits.
2022-12-22 Updated TMR0 to 20ms, implemented dropping from Service Mode.
    Renamed dcc_performance to dcc_periodic to better reflect it's function.
    Set TMR0 to call it every 20ms.
    Update statitics printing to continue to be once per second.
    Implement dropping out of a service mode.
    Move the CV8=8 factory reset logic into the CV handling so that
    it works no matter how the CV is written.
    Update documentation.
    [cv.c, dcc.c, dcc.h, main.c]
2022-12-23 Attempt to refactor with all SOT-23 components for cost, availability.
    Also makes it more possible to hand-solder.
    [Breadboard-1.kicad_pcb, Breadboard-1.kicad_sch]
2023-09-10 Cleanup of the final PCB.
    Moved components to grid coordinates.
    Added in some labels for the user.
    Cleaned up some trace routing, and made it pretty where possible.
    [Breadboard-1.kicad_pcb, Breadboard-1.kicad_sch]
2023-09-10 Generated updated .JPG and .PDF for documentation.
    [Breadboard-1.kicad_pcb]
2023-09-11 Minor design tweak, update documentation.
    Moved the MCLEAR hold up components to make the board design cleaner.
    Updated all the documentation to match the current configuration.
    [Breadboard-1.kicad_pcb, Breadboard-1.kicad_sch]
2023-09-11 Add warning about resistor to README.
2023-09-11 Bring inline with Breadboard-1 reference design.
    Add digital transitor drivers for the high side of the H-Bridge.
    Add third BEMF resistor.
    Relocate noise capacitor.
    [Wired-N-1A-6-1.kicad_pcb, Wired-N-1A-6-1.kicad_sch]
2023-09-11 Fixed misaigned labels and regenerated 3D.
    [Breadboard-1.kicad_pcb]
2023-09-14 Manufacturability changes.
    Added 3 fiducial markers to support pick and place in volume.
    Resized all the traces to be manufacturable with the popular board fabs.
    Moved traces based on the new size.
    Standardized vias to one size larger than the general manufacturing minimum.
    Improved grounding around the CPU.
    [Breadboard-1.kicad_pcb, Breadboard-1.kicad_sch]
2023-09-15 Updated BOM to optimize for JLCPCB production.
    Used as many JLCPCB "basic" parts as possible, optimized for
    the cheapest parts in stock as of today.
    [Breadboard-1.kicad_sch]
2023-09-15 Updates based on feedback from JLCPCB online tools.
    [Breadboard-1.kicad_pcb, Breadboard-1.kicad_sch]
2023-09-16 Pile of minor corrections for sharing and production.
    1. Remove .DS_Store files mistakenly added.
    2. Correctly relatively path project footprints and symbols.
    3. Add footprint for JLCPCB's required tooling hole to use their assembly service.
    4. Tweak a few tracks and description placements to enhance readability.
    [Breadboard-1.kicad_pcb, Breadboard-1.kicad_sch]
2023-09-16 Updated TODO items to match the current reality.
2023-09-16 Turned feature list into checkboxes to track progress.
2023-09-18 Moved CALCULATIONS to a spreadsheet.
    Moved the calculations into a spreadsheet so that the values would
    dynamically change when components needed to be updated. Used the
    dynamic capabilities along with the JLCPCB parts list to update
    resistor values to have more common values and use JLCPCB basic
    parts values.
    Determined also that the calculations on the DCC input were wrong
    in the previous file and added D21 to clamp the input and protect
    the PIC.
    Fixed the "Values" in the BOM so the components group properly.
    This required also updating a number of silk screen items.
    Added the copyright notice and URL to the back of the board.
    [Breadboard-1.kicad_pcb, Breadboard-1.kicad_sch, CALCULATIONS.xlsx]
2023-09-18 Added missing ground trace and regenerated image.
    [Breadboard-1.kicad_pcb]
2023-09-18 Save JLCPCB preferred gerber options.
    [Breadboard-1.kicad_pcb]
2023-09-18 Missed 'Load En' in previous rework.
    [Breadboard-1.kicad_pcb]
2023-09-18 Update board color to blue w/white silkscreen.
    [Breadboard-1.kicad_pcb]
2023-09-19 Initial draft of a super-mineature F0F/F0R N-scale decoder.
    [Wired-N-1A-2-1.kicad_pcb, Wired-N-1A-2-1.kicad_sch]
2023-09-24 Renamed Wired-N-1A-6-1 to Wired-N-1A-8-1.
    [Wired-N-1A-8-1.kicad_pcb, Wired-N-1A-8-1.kicad_sch]
2023-09-25 Improved calculations, and other updates as a result.
    Switched to tantalum capacitors per the data sheet recommendation
    for the regulator. Reworked board to accomodate.
    Switched DCC input to be through a MOSFET to accomodate the track
    voltage range.
    Re-organized schematic so the blocks make more sense, changed to
    US Letter paper, and re-annotated so each block has it's own 10's
    range.
    Updated CALCULATIONS.xlsx, including page formatting, reworked it
    so there is one tab per block on the schematic, and re-checked all
    calculations. It now prints to paper pretty.
    Updated all resistor values to match a 3.3v microprocessor and
    JLCPCB basic parts availability.
    Updated MCLR hold up circuit to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
    [Breadboard-1.kicad_pcb, Breadboard-1.kicad_sch]
2023-09-25 Updated README to match the new schematic blocks.
2023-09-25 Fixed broken links and generated image and schematics.
    [Wired-N-1A-2-1.kicad_pcb]
2023-09-26 Switched regulator, added "super capacitor" location.
    Switched the linear regulator to a SE8633X2-HF which has superior
    performance characteristics. Switched back to 0805 10uF resistors
    as a result. Reworked regulator area, using copper fills to lower
    resistance between components per data sheet recomendation.
    Added C11, a spot for an electrolytic "super capacitor" of up to 1000uF
    to help smooth out input electrical issues. Moved a few traces to make
    space for it.
    Updated CALCULATIONS.xlsx to match. Regenerated .jpg and .pdf.
    [Breadboard-1.kicad_pcb, Breadboard-1.kicad_sch, CALCULATIONS.xlsx]
2023-09-26 Updated description to include super capacitor.
2023-09-27 Tweaked the board to shave 2mm, now 9mm x 18mm.
    [Wired-N-1A-2-1.kicad_pcb, Wired-N-1A-2-1.kicad_sch]
2023-09-29 Plot paramters to get good gerbers.
    [Breadboard-1.kicad_pcb, Breadboard-1.kicad_sch]
2023-10-02 Correct over-voltage on high side drive.
    The P-Channel MOSFET gate would be driven to 0v by the old driver
    circuit. When the DCC voltage is > 20v, this exceeds the Vgs
    maximum of the part.
    Added another resistor to make a voltage divider cutting the voltage
    in half, and thus driving the gate at 15v when Vdrive is 30v. Now
    Vgs is always within range of the part.
    [Breadboard-1.kicad_pcb, Breadboard-1.kicad_sch, CALCULATIONS.xlsx]
2023-10-02 Initial draft of the decoder.
    [Atlas-N-1A-2-GP40-1.kicad_pcb, Atlas-N-1A-2-GP40-1.kicad_sch, CALCULATIONS.xlsx]
2023-10-04 Clarity improvements.
    1) Moved the dummy load block on the schematic so the external connectivity
    block could be larger. This enables desgins that need more external
    connectivity (e.g. Wired-Altas-1A-2) to use the same schematic layout.
    2) Updated CALCULATIONS tab numbering to include component numbers in that
    block.
    3) Updated CALCULATIONS for the motor driver to include a discussion about
    gate resistor selection and gate driving timers.
    [Breadboard-1.kicad_pcb, Breadboard-1.kicad_sch, CALCULATIONS.xlsx]
2023-10-04 Ensure power traces can handle 1A, cosmetic cleanup.
    1) Enlarged traces that will carry large currents to insure they
    are of sufficient size.
    2) Make sure everything was aligned on an inch/mil grid. Moved components
    to provide more board space for the wider traces. General make it pretty.
    [Breadboard-1.kicad_pcb]
2023-10-04 Fixed up text on the fab layer.
    [Breadboard-1.kicad_pcb]
2023-10-04 Small corrections.
    [Atlas-N-1A-2-GP40-1.kicad_pcb, Atlas-N-1A-2-GP40-1.kicad_sch]
2023-10-04 Update to be current.
2023-10-06 Software with working function effects & motor control.
    Implemented basic function effects, some look good, some still
    need tweaking.
    Corrected the motor control code so the outputs are correct.
    [functions.c, functions.h, motor.c, motor.h]
2023-10-07 Updated MOSFETS to be ESD protected versions. Updated calculations.
    [Breadboard-1.kicad_pcb, Breadboard-1.kicad_sch, CALCULATIONS.xlsx]
2023-10-08 Parts update, moved descriptive language from README to CALCULATIONS.
    Updated MOSFET selection, again.
    Moved all block descriptions from README into CALCULATIONS so they are
    not duplicated.
    Improved some descriptions.
    [Breadboard-1.kicad_sch, CALCULATIONS.xlsx]
2023-10-17 Improved routing based on online feedback.
    [Breadboard-1.kicad_pcb]
2023-10-18 Improve manufacturability.
    [Breadboard-1.kicad_pcb]
2023-10-22 Initial hardware implementation of a STM32 processor.
    Replace the SSOP-20 PIC18F processor with a TSSOP-20 STM32 processor.
    Where possible IO was kept on the same pin number to avoid re-routing
    additonal traces. Minor changes were needed to the decoupling capacitors
    as well as the programming header.
    [Breadboard-2.kicad_pcb, Breadboard-2.kicad_sch, CALCULATIONS.xlsx]
2023-10-22 Correct data sheet link.
    [Breadboard-2.kicad_sch]
2023-10-22 Replace +5V to +3V3 in schematic to properly reflect voltage.
    [Breadboard-1.kicad_sch]
2023-10-22 Move DCC_IN and BackEMF to pins with appropriate capabilities.
    STM32 does not allow software remapping of the periperhal input
    pins. The location in the PIC design (Breadboard-1) routes them
    to pins on an STM32 that are designed for the oscellator, but can
    be re-used. As such they have no ADC or Timer triggers attached
    to them.
    DCC_IN was moved to port 20, which can be routed to any of
    TIM1_CH2, TIM2_CH2, TIM3_CH1, TIM3_CH2, TIM1_CH3, TIM16_CH1N.
    BackEMF was moved to pin 7, which can be routed to ADC_IN0.
    The displaced P1C H-Bridge output was moved to pin 2, as it's more
    than capable of outputting the necessary signal.
    [Breadboard-2.kicad_pcb, Breadboard-2.kicad_sch]
2024-03-18 Initial partial port of software to the STM32 platform.
    This code is destined to go with Breadboard-2, but for now is being
    developed and tested on an NUCLEO-F103RB board. It's done in
    STM32CubeIDE and uses the full set of hardware abstrations.
    The motor code and function code has not yet been ported, and a
    sync between this and the PIC code needs to happen.
2024-03-18 Add initialization functions.
    Initial import missed some initialization functions in main, add
    them back in to restore full functionality.
    [debug.h, main.c]
