bicknell/DCC-Mobile-Decoder/(notices)

Notices in the files:
software/reference/Breadboard-2/Core/Src/main.c:
Copyright (c) 2024 STMicroelectronics.
All rights reserved.
This software is licensed under terms that can be found in the LICENSE file
hardware/reference/Breadboard-2/Breadboard-2.kicad_pcb:
Public License, see the file LICENSE for
